marouncz/GraviGon/boards.png

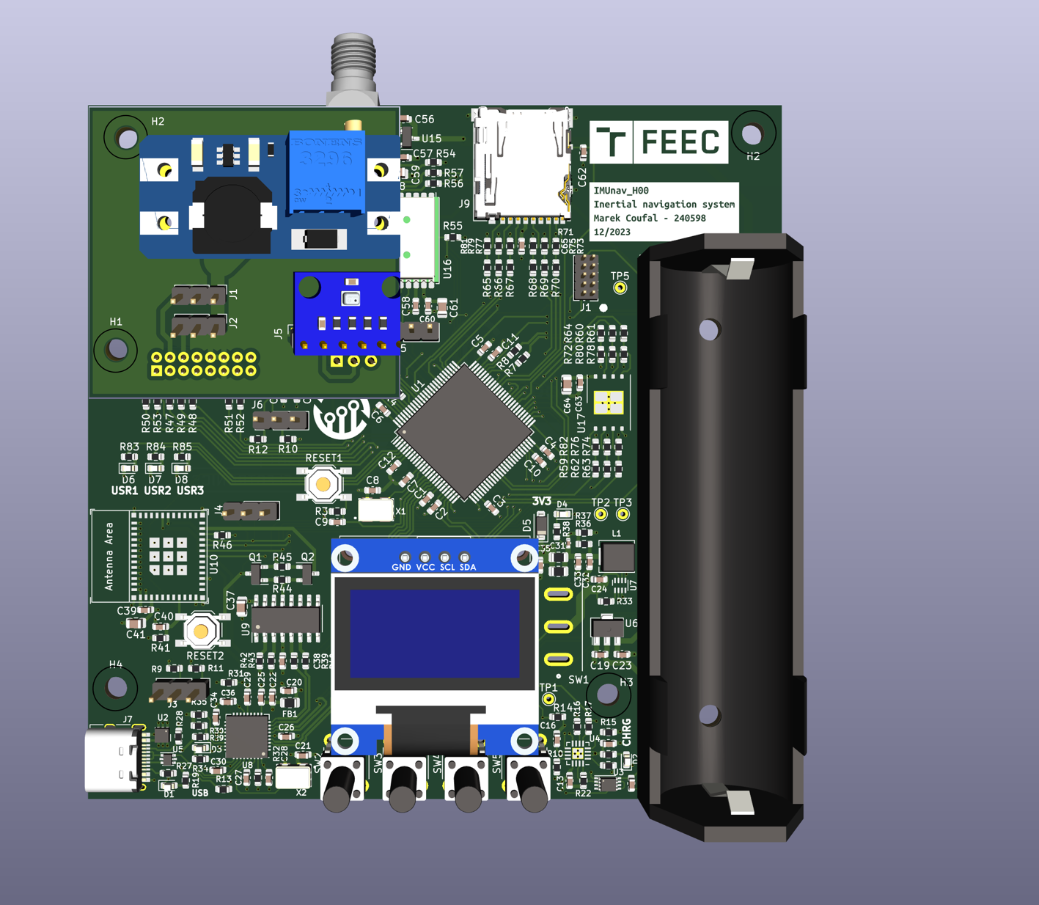
boards.png
