marouncz/GraviGon/boardReal.jpg

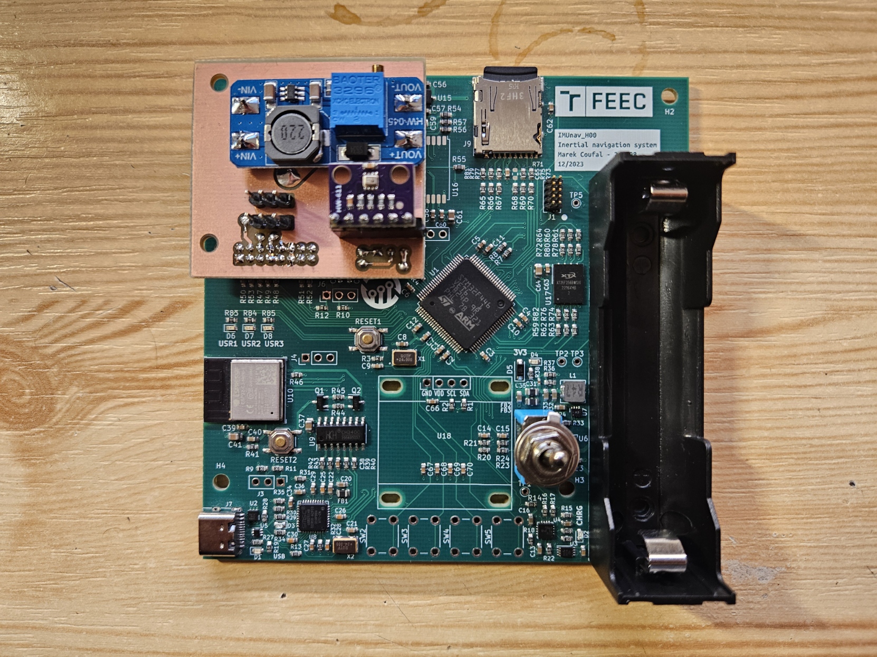
boardReal.jpg
