marouncz/GraviGon/Mechanics/NDE_CubeSat_v2/Cubesat/Cubesat_Go.pdf

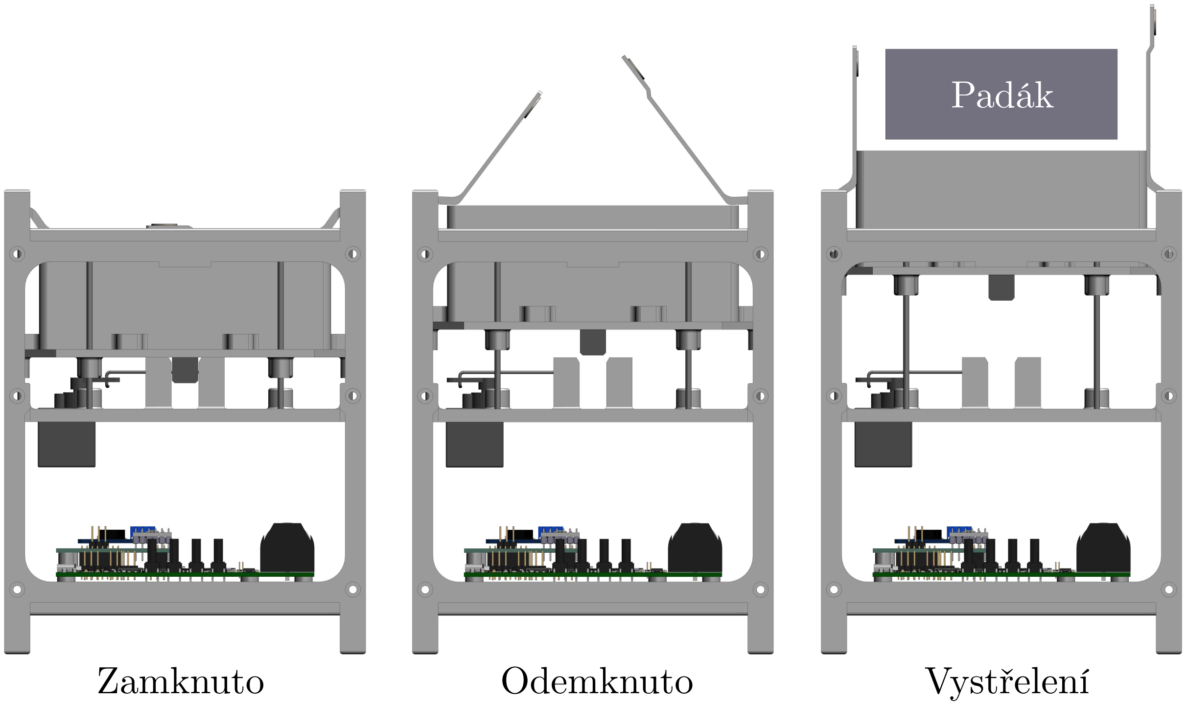
[picture p3: page 1]

Zamknuto | Odemknuto | Vystřelení

Padák
