marouncz/GraviGon/boardMating.png

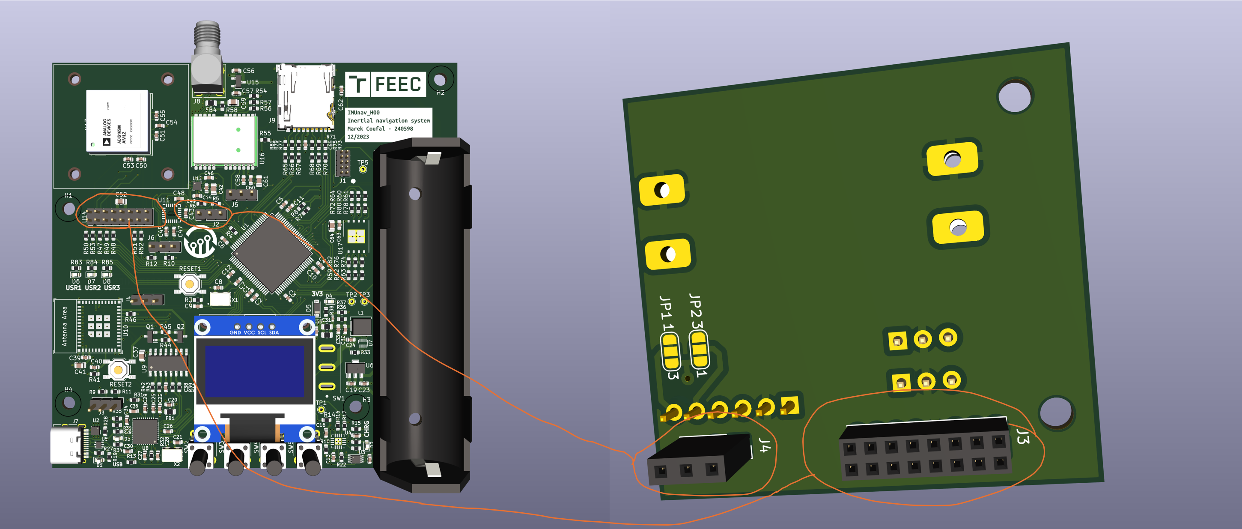
boardMating.png
