marouncz/GraviGon/Mechanics/NDE_CubeSat_v2/Cubesat/Center_of_mass_MPU6050_2.jpg

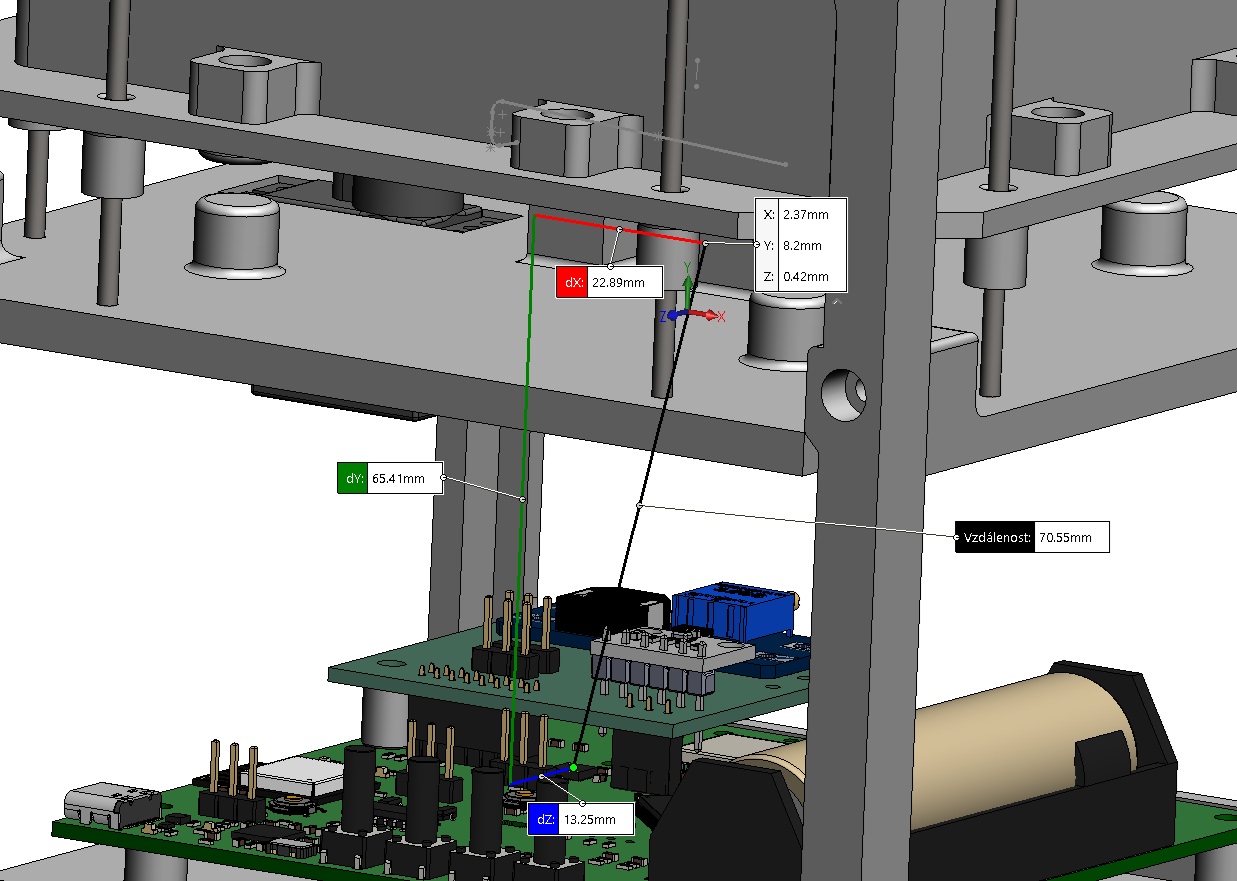
Mechanics/NDE_CubeSat_v2/Cubesat/Center_of_mass_MPU6050_2.jpg
