marouncz/GraviGon/Mechanics/NDE_CubeSat_v2/Cubesat/Cubesat.jpg

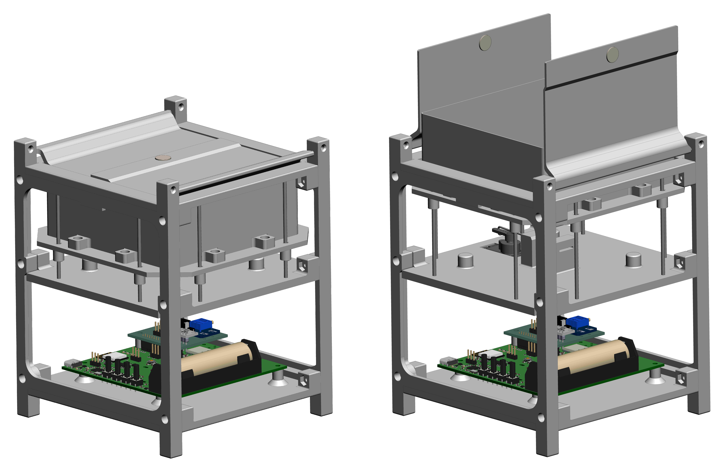
Mechanics/NDE_CubeSat_v2/Cubesat/Cubesat.jpg
