marouncz/GraviGon/Mechanics/NDE_CubeSat_v2/Cubesat/Cubesat_Go_1.JPG

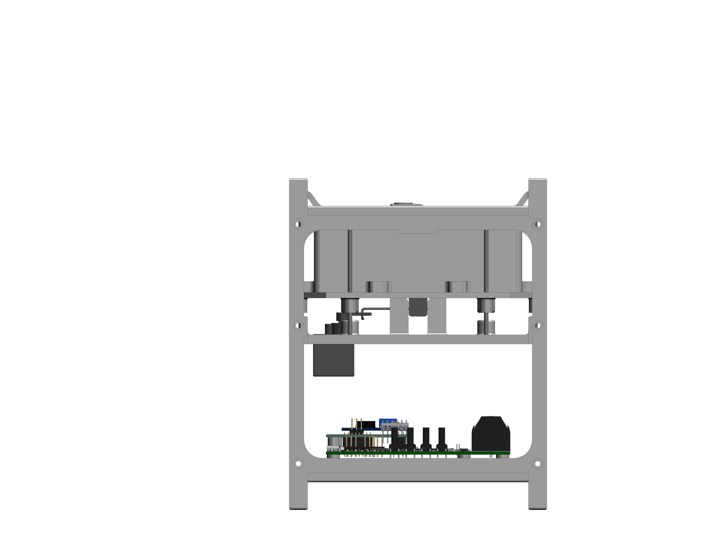
Mechanics/NDE_CubeSat_v2/Cubesat/Cubesat_Go_1.JPG
