marouncz/GraviGon/Mechanics/NDE_CubeSat_v2/Cubesat/Cubesat_Go_3.JPG

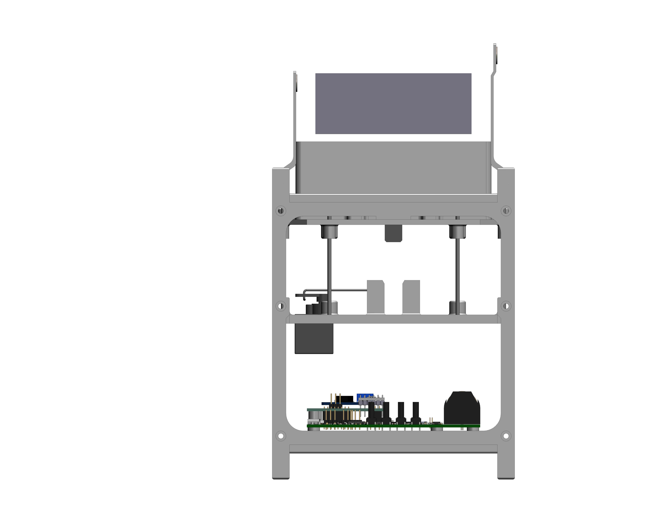
Mechanics/NDE_CubeSat_v2/Cubesat/Cubesat_Go_3.JPG
