marouncz/GraviGon/Mechanics/NDE_CubeSat_v2/Cubesat/Cubesat_Mooving_Part.JPG

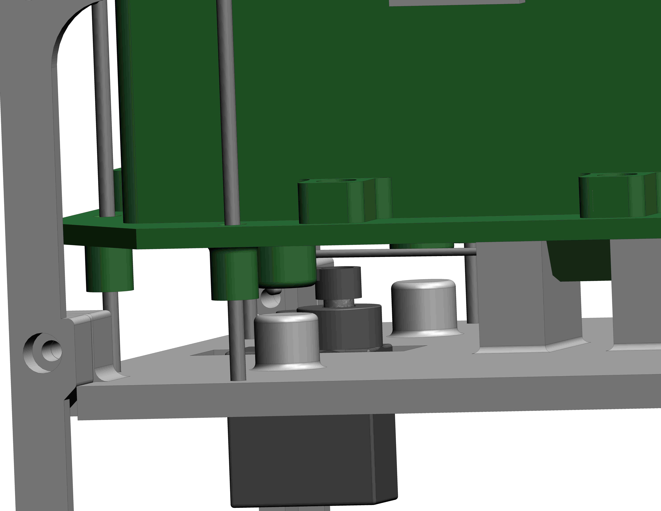
Mechanics/NDE_CubeSat_v2/Cubesat/Cubesat_Mooving_Part.JPG
