marouncz/GraviGon/Mechanics/NDE_CubeSat_v2/Cubesat/Cubesat_Release_1.JPG

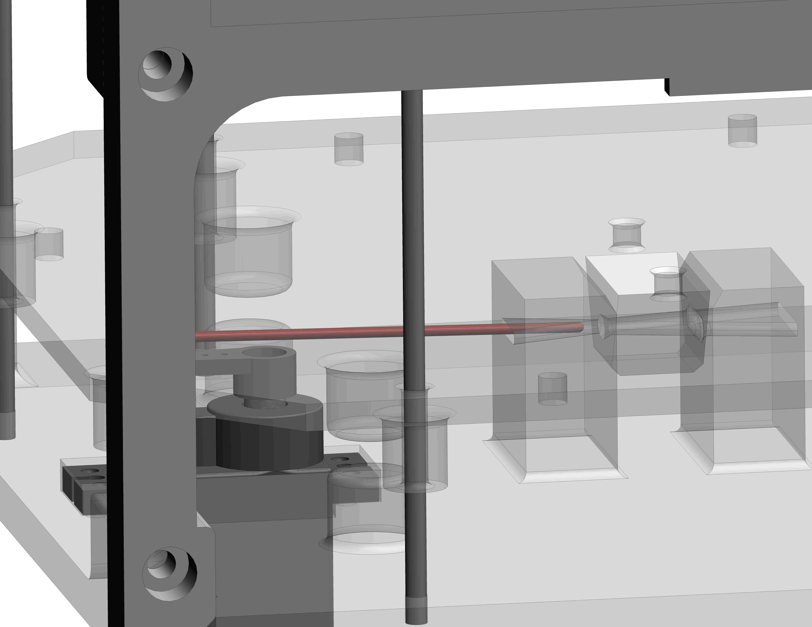
Mechanics/NDE_CubeSat_v2/Cubesat/Cubesat_Release_1.JPG
