marouncz/GraviGon/Mechanics/NDE_CubeSat_v2/Cubesat/Cubesat_Release_DPI300.jpg

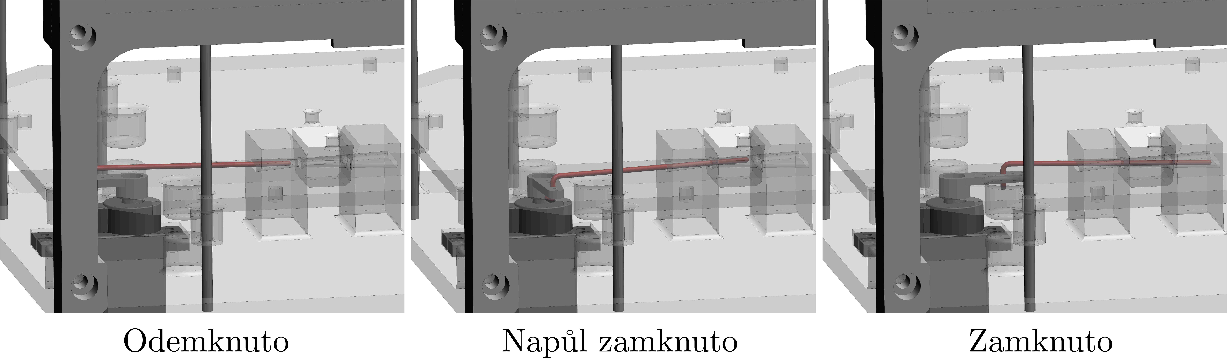
Mechanics/NDE_CubeSat_v2/Cubesat/Cubesat_Release_DPI300.jpg
