marouncz/GraviGon/Mechanics/NDE_CubeSat_v2/Cubesat/Print_Parts_Progress.xlsx

Filename | pcs | infill | progress
Cubesat_Bottom.STL | 1 | 30% |  | done
Cubesat_Middle.STL | 1 | 50% |  | printing
Cubesat_Moving_Part_v2.STL | 1 | 90% |  | to do
Cubesat_Side.STL | 2 | 50%
Cubesat_Side_Parachute_Cover.STL | 1 | 90%
Cubesat_Top.STL | 1 | 30%
Cubesat_Top_Cover_Right.STL | 1 | 90%
Cubesat_Top_Cover_Left.STL | 1 | 90%
