marouncz/GraviGon/Mechanics/NDE_CubeSat_v2/Cubesat/BOM_Screws_Nuts.xlsx

Part | pcs | info | take
DIN 912 M3x16 | 16 | imbus šroub s válcovou hlavou | 20
DIN 912 M3x26 | 1 | imbus šroub s válcovou hlavou | 2
DIN 912 M3x10 | 8 | imbus šroub s válcovou hlavou | 10
DIN 912 M2x6 | 2 | imbus šroub s válcovou hlavou | 4
DIN 912 M2x14 | 1 | imbus šroub s válcovou hlavou | 2
DIN 934 M3 | 25 | hex matice | 30
DIN 934 M2 | 3 | hex matice | 6
