marouncz/GraviGon/Mechanics/NDE_CubeSat_v2/Cubesat/Cubesat_SG90.SLDASM

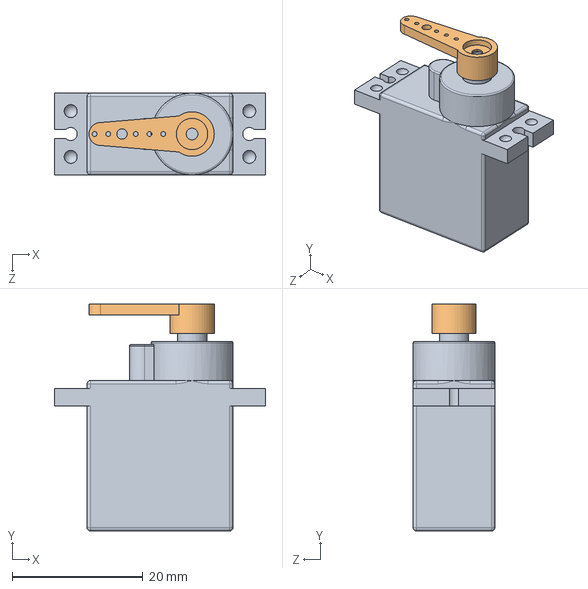
[picture p14: CAD file, 2025-05-04]
Mechanics/NDE_CubeSat_v2/Cubesat/Cubesat_SG90.SLDASM
32.3 x 34.7 x 12.5 mm
Cubesat_SG90_Body
Cubesat_SG90_Moving_Part
