marouncz/GraviGon/Mechanics/NDE_CubeSat_v2/Board/IMUnav_H00_Addon.SLDASM

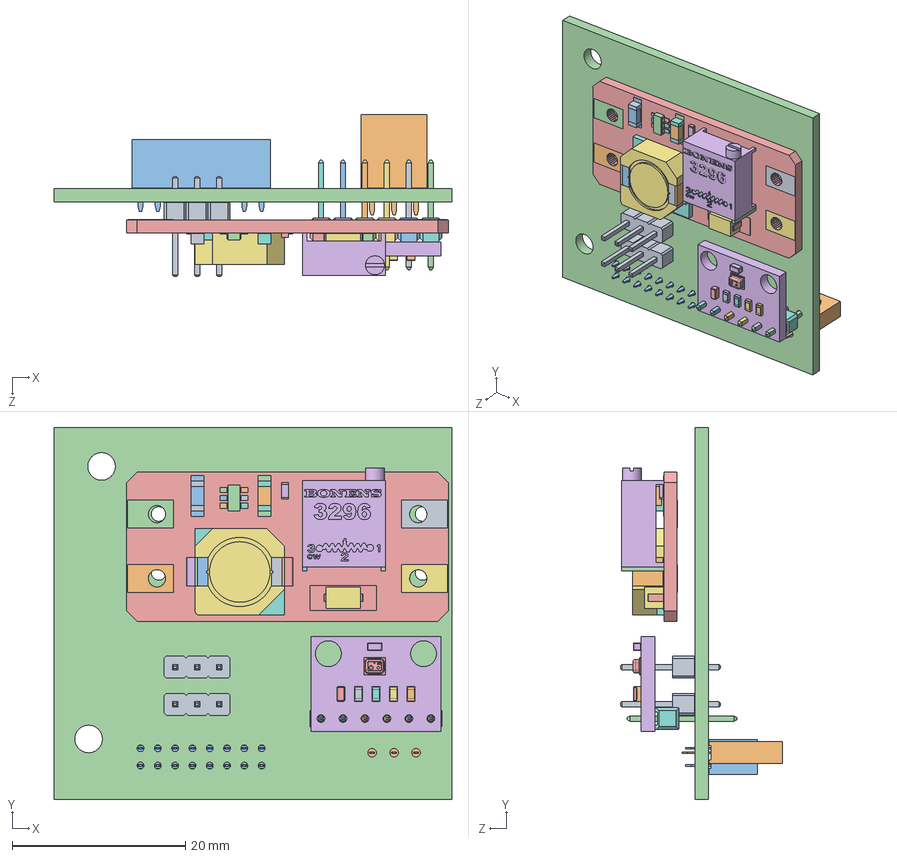
[picture p15: CAD file, 2025-04-14]
Mechanics/NDE_CubeSat_v2/Board/IMUnav_H00_Addon.SLDASM
46.0 x 43.0 x 18.7 mm
MT3608 v3
MT3608 v3_44
MT3608 v3_28
MT3608 v3_26
MT3608 v3_13
MT3608 v3_41
MT3608 v3_11
MT3608 v3_29
MT3608 v3_42
MT3608 v3_43
MT3608 v3_15
MT3608 v3_16
MT3608 v3_14
MT3608 v3_30
MT3608 v3_39
MT3608 v3_9
MT3608 v3_10
MT3608 v3_12
MT3608 v3_31
MT3608 v3_17
MT3608 v3_8
MT3608 v3_40
MT3608 v3_27
MT3608 v3_2
MT3608 v3_33
MT3608 v3_3
MT3608 v3_18
MT3608 v3_19
MT3608 v3_22
MT3608 v3_4
MT3608 v3_35
MT3608 v3_20
MT3608 v3_34
MT3608 v3_5
MT3608 v3_6
MT3608 v3_21
MT3608 v3_7
MT3608 v3_23
MT3608 v3_37
MT3608 v3_38
MT3608 v3_36
MT3608 v3_24
MT3608 v3_25
MT3608 v3_32
bmp280_module_Shrinkwrap
bmp280_module_Shrinkwrap_16
bmp280_module_Shrinkwrap_10
bmp280_module_Shrinkwrap_9
bmp280_module_Shrinkwrap_2
bmp280_module_Shrinkwrap_17
bmp280_module_Shrinkwrap_5
bmp280_module_Shrinkwrap_13
bmp280_module_Shrinkwrap_12
bmp280_module_Shrinkwrap_11
bmp280_module_Shrinkwrap_19
bmp280_module_Shrinkwrap_6
bmp280_module_Shrinkwrap_7
bmp280_module_Shrinkwrap_15
bmp280_module_Shrinkwrap_4
bmp280_module_Shrinkwrap_8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
