marouncz/GraviGon/Electronics/IMUnav_Gravi_Addon/bmp280_module.stp

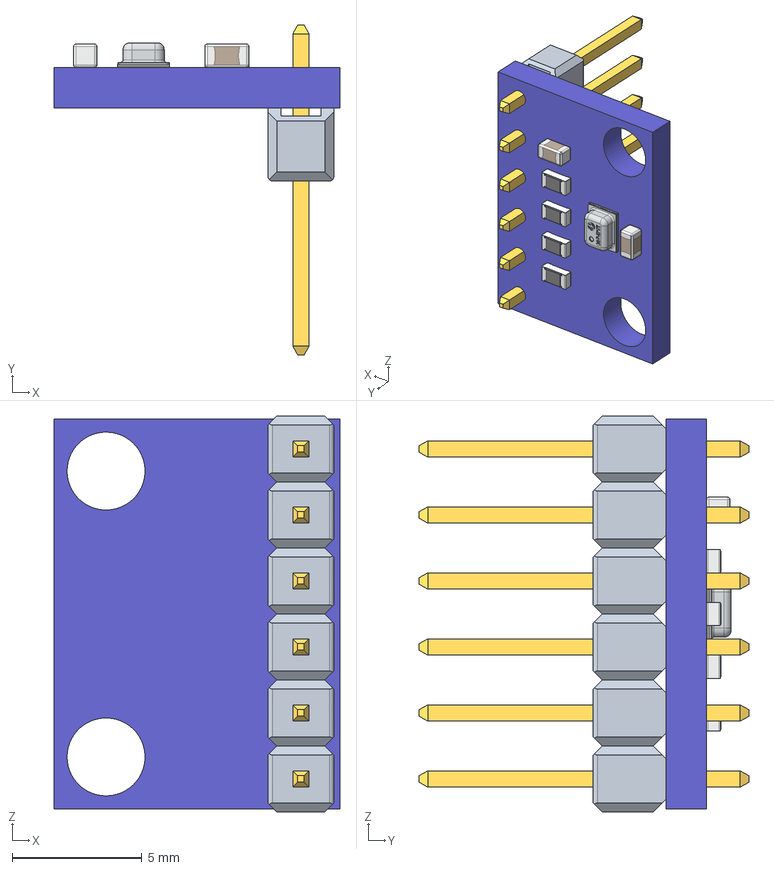
[picture p16: CAD file, 2025-02-20]
Electronics/IMUnav_Gravi_Addon/bmp280_module.stp
11.0 x 12.7 x 15.2 mm
