marouncz/GraviGon/Mechanics/NDE_CubeSat_v2/Cubesat/Cubesat_Moving_Part_v2.SLDPRT

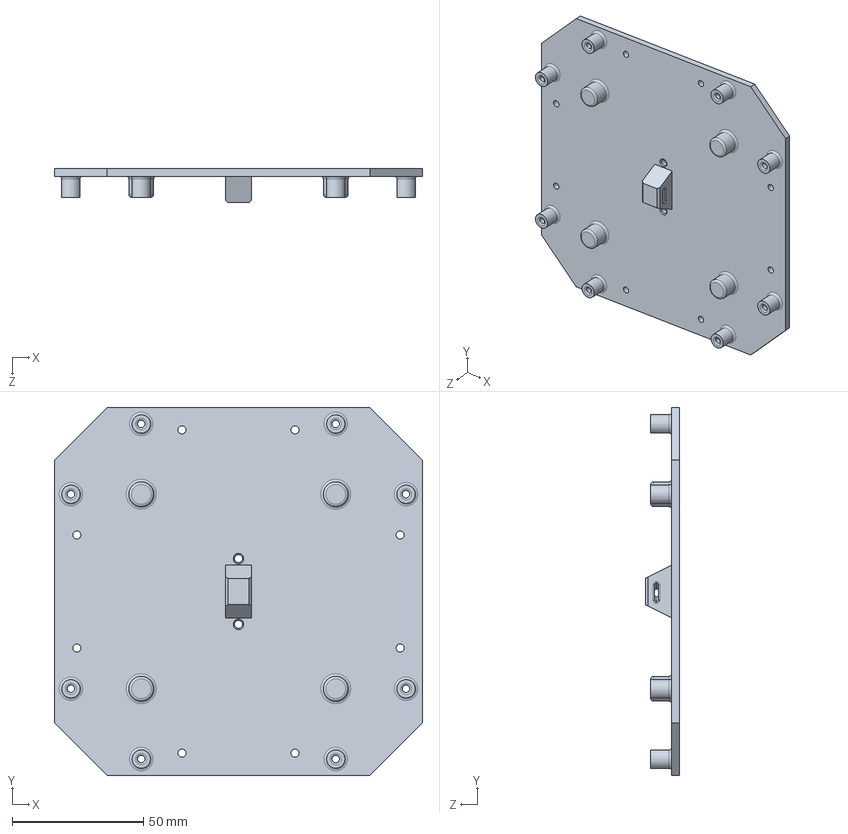
[picture p17: CAD file, 2025-05-04]
Mechanics/NDE_CubeSat_v2/Cubesat/Cubesat_Moving_Part_v2.SLDPRT
140.0 x 140.0 x 13.0 mm
