marouncz/GraviGon/Electronics/IMUnav_Gravi_Addon/MT3608 v3.step

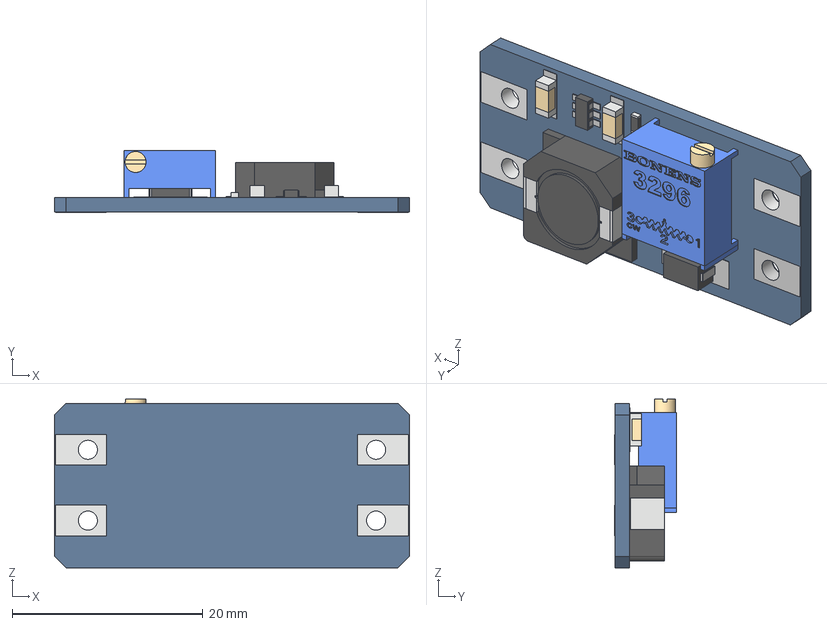
[picture p18: CAD file, 2025-02-20]
Electronics/IMUnav_Gravi_Addon/MT3608 v3.step
37.2 x 6.49 x 17.7 mm
