marouncz/GraviGon/Mechanics/NDE_CubeSat_v2/Cubesat/Cubesat_Fuse_Wire.SLDPRT

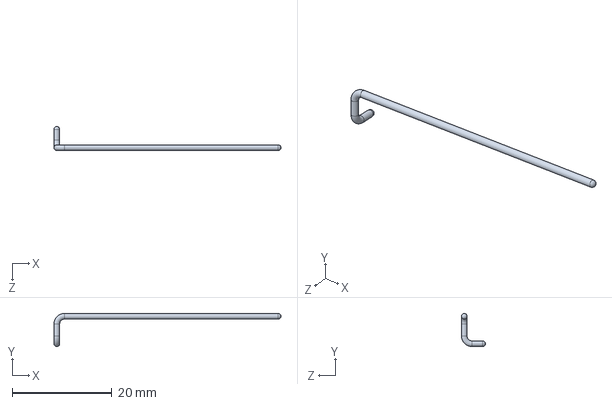
[picture p19: CAD file, 2025-05-04]
Mechanics/NDE_CubeSat_v2/Cubesat/Cubesat_Fuse_Wire.SLDPRT
45.6 x 6.65 x 4.83 mm
