marouncz/GraviGon/Mechanics/NDE_CubeSat_v2/Cubesat/Cubesat_Side_Parachute_Cover.SLDPRT

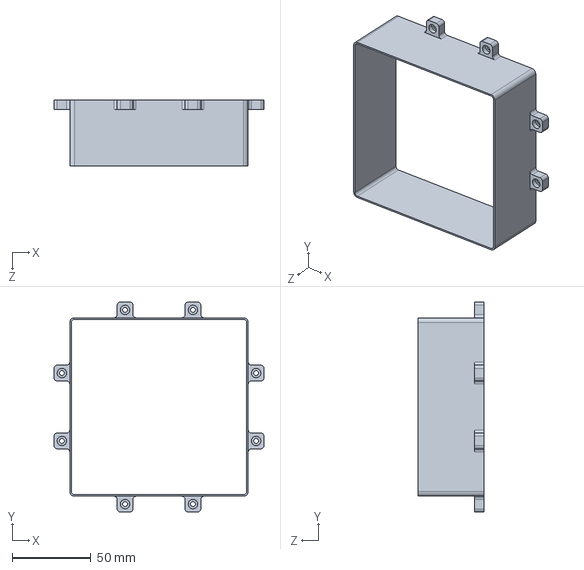
[picture p20: CAD file, 2025-05-04]
Mechanics/NDE_CubeSat_v2/Cubesat/Cubesat_Side_Parachute_Cover.SLDPRT
133.0 x 133.0 x 42.0 mm
