marouncz/GraviGon/Mechanics/NDE_CubeSat_v2/Cubesat/Cubesat_Side.SLDPRT

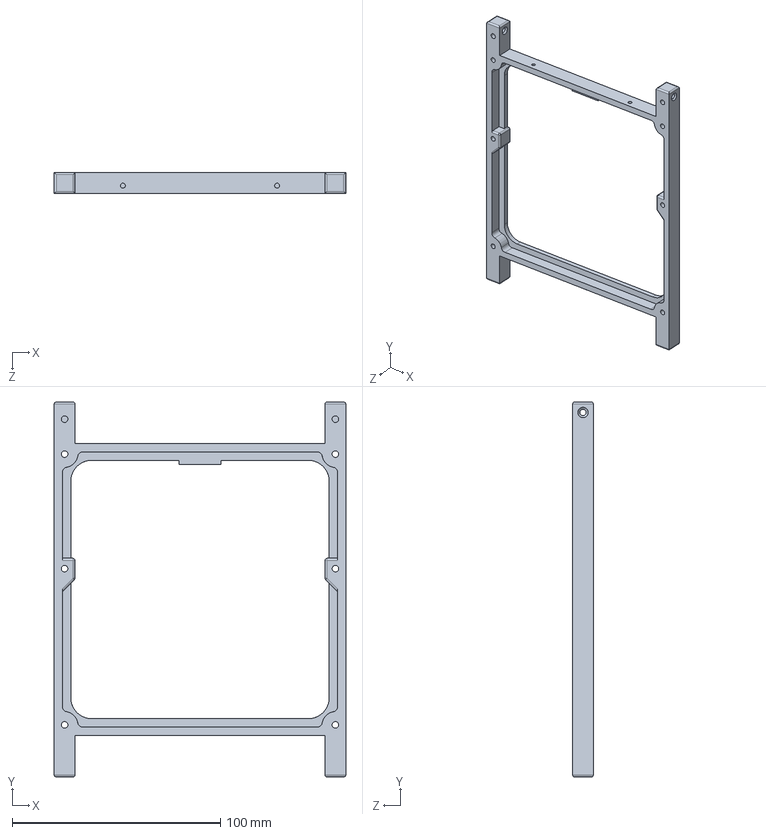
[picture p22: CAD file, 2025-04-14]
Mechanics/NDE_CubeSat_v2/Cubesat/Cubesat_Side.SLDPRT
140.0 x 180.0 x 10.0 mm
