marouncz/GraviGon/Mechanics/NDE_CubeSat_v2/Cubesat/Cubesat_SG90_Body.SLDPRT

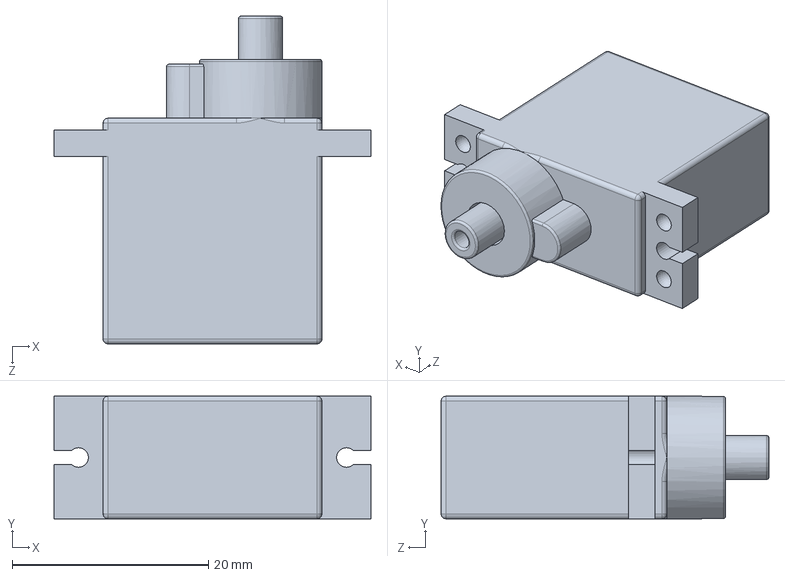
[picture p23: CAD file, 2025-04-14]
Mechanics/NDE_CubeSat_v2/Cubesat/Cubesat_SG90_Body.SLDPRT
32.3 x 12.5 x 33.4 mm
