marouncz/GraviGon/Mechanics/NDE_CubeSat_v2/Cubesat/Cubesat_SG90_Moving_Part.SLDPRT

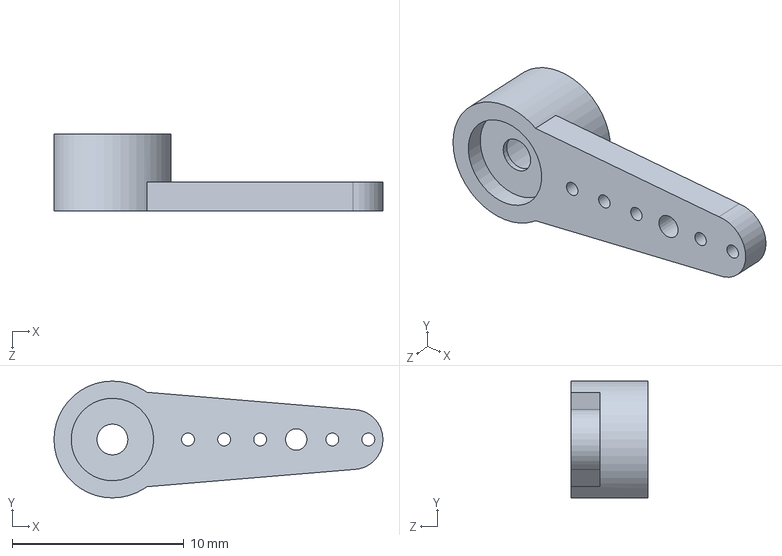
[picture p24: CAD file, 2025-04-14]
Mechanics/NDE_CubeSat_v2/Cubesat/Cubesat_SG90_Moving_Part.SLDPRT
19.1 x 6.80 x 4.50 mm
