marouncz/GraviGon/Mechanics/NDE_CubeSat_v2/Board/Board.SLDPRT

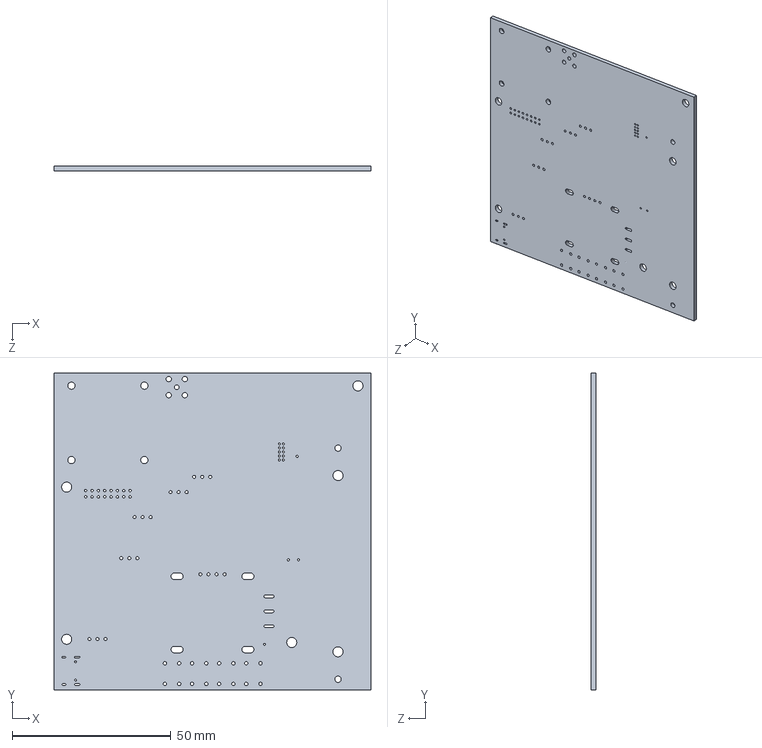
[picture p25: CAD file, 2025-04-14]
Mechanics/NDE_CubeSat_v2/Board/Board.SLDPRT
100.0 x 100.0 x 1.65 mm
