marouncz/GraviGon/Mechanics/NDE_CubeSat_v2/Cubesat/Cubesat_Parachute.SLDPRT

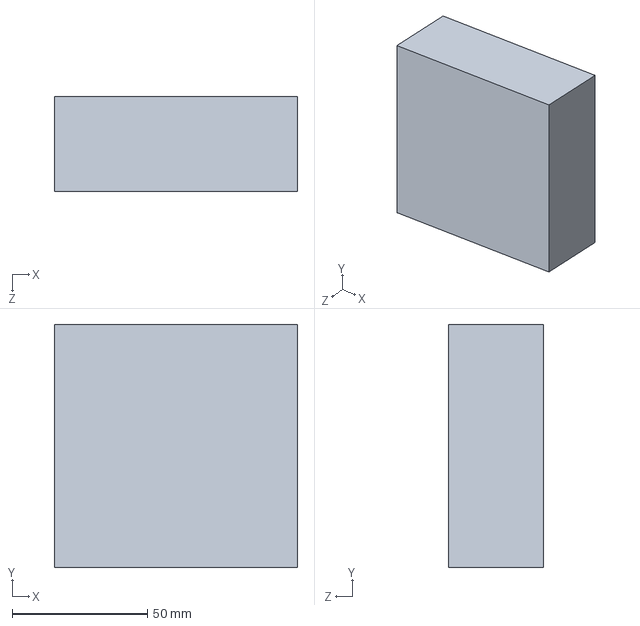
[picture p26: CAD file, 2025-04-14]
Mechanics/NDE_CubeSat_v2/Cubesat/Cubesat_Parachute.SLDPRT
90.0 x 90.0 x 35.0 mm
