marouncz/GraviGon/Mechanics/NDE_CubeSat_v2/Cubesat/Cubesat_Spacer_Real.SLDPRT

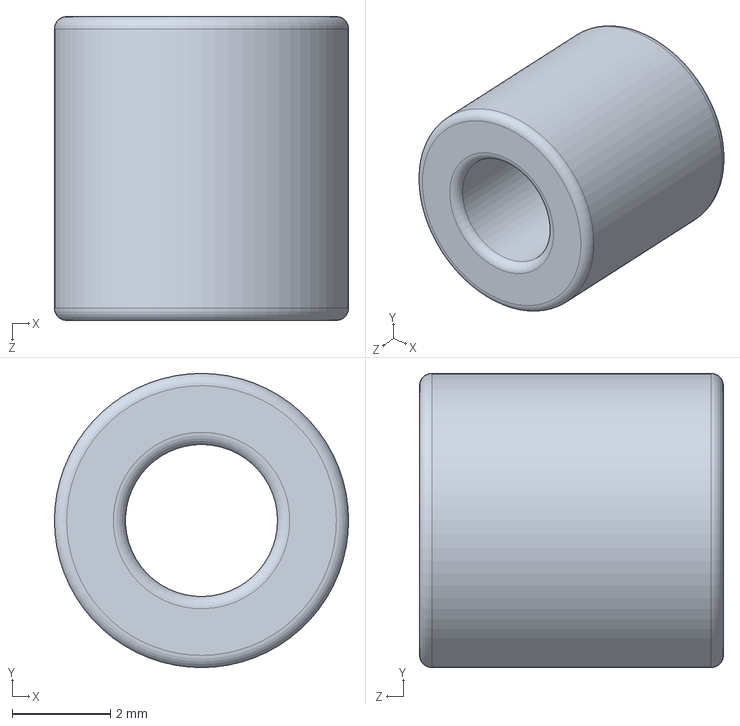
[picture p27: CAD file, 2025-04-14]
Mechanics/NDE_CubeSat_v2/Cubesat/Cubesat_Spacer_Real.SLDPRT
6.00 x 6.00 x 6.20 mm
