marouncz/GraviGon/Mechanics/NDE_CubeSat_v2/Cubesat/Cubesat_Top_Cover_Right.STL

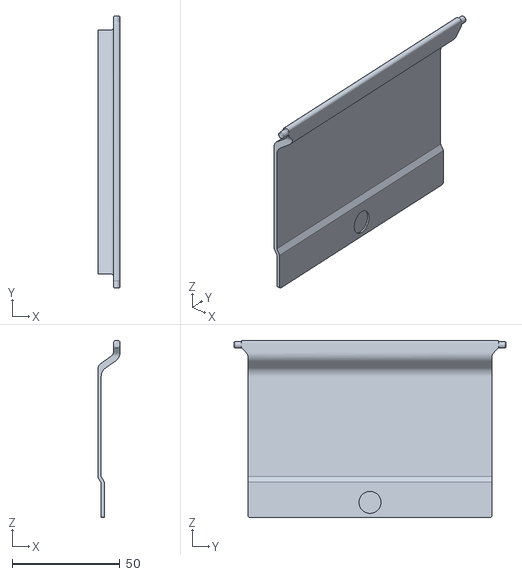
[picture p28: CAD file, 2025-04-14]
Mechanics/NDE_CubeSat_v2/Cubesat/Cubesat_Top_Cover_Right.STL
10.2 x 126.0 x 82.0
