marouncz/GraviGon/Mechanics/NDE_CubeSat_v2/Cubesat/Cubesat_Top_Cover.SLDPRT

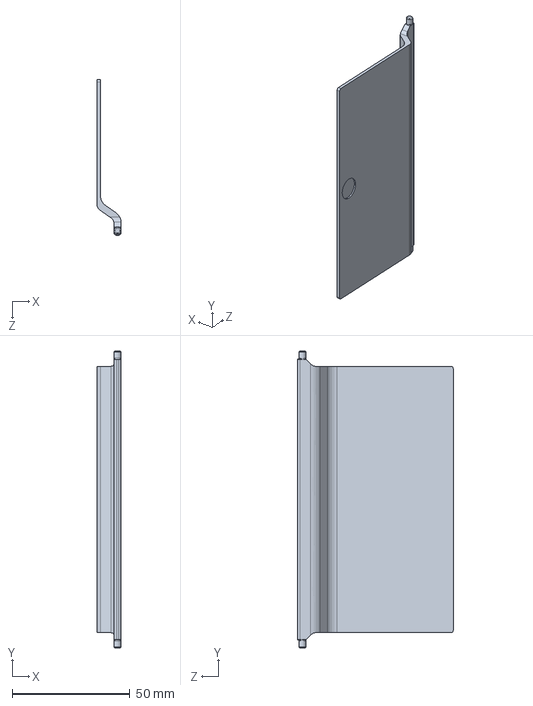
[picture p29: CAD file, 2025-04-14]
Mechanics/NDE_CubeSat_v2/Cubesat/Cubesat_Top_Cover.SLDPRT
10.2 x 126.0 x 66.0 mm
