marouncz/GraviGon/Mechanics/NDE_CubeSat_v2/Cubesat/Cubesat_Middle.SLDPRT

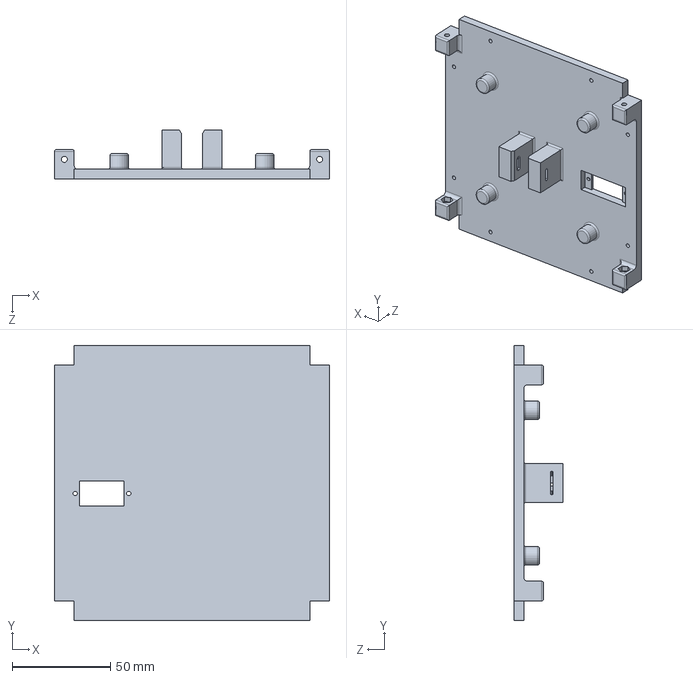
[picture p30: CAD file, 2025-04-14]
Mechanics/NDE_CubeSat_v2/Cubesat/Cubesat_Middle.SLDPRT
140.0 x 140.0 x 25.0 mm
