marouncz/GraviGon/Mechanics/NDE_CubeSat_v2/Cubesat/Cubesat_Wire.SLDPRT

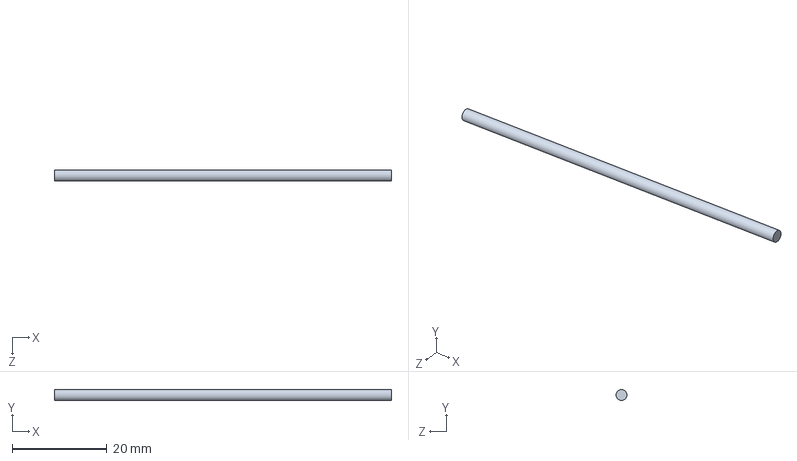
[picture p31: CAD file, 2025-04-14]
Mechanics/NDE_CubeSat_v2/Cubesat/Cubesat_Wire.SLDPRT
71.0 x 2.30 x 2.30 mm
