marouncz/GraviGon/Mechanics/NDE_CubeSat_v2/Cubesat/Cubesat_Top.SLDPRT

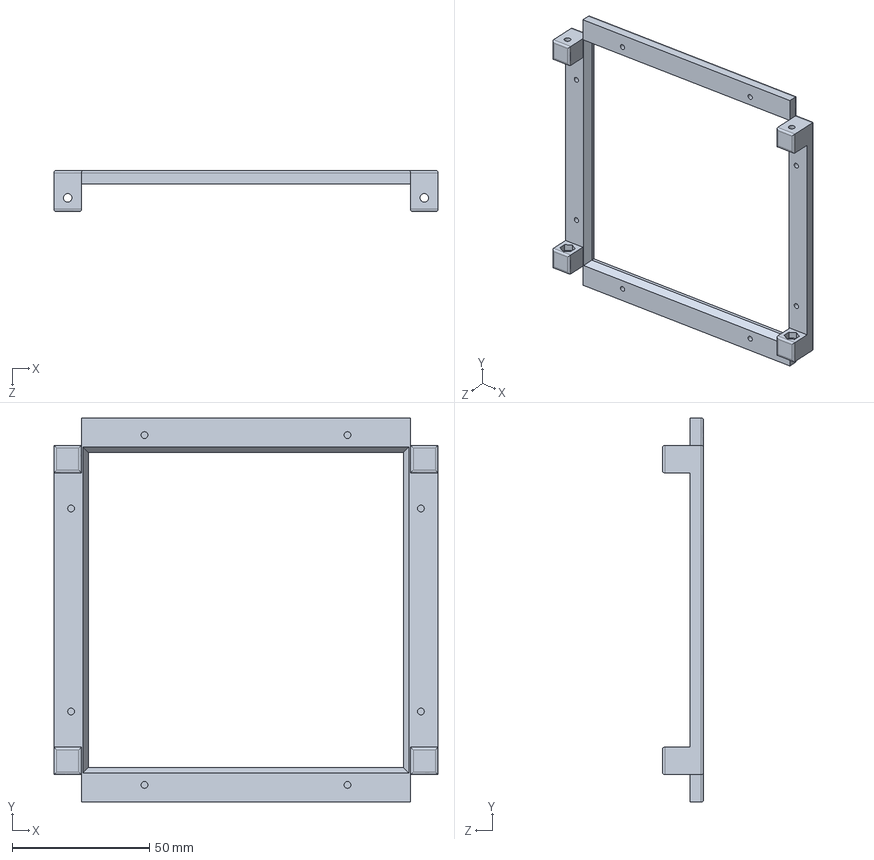
[picture p32: CAD file, 2025-04-14]
Mechanics/NDE_CubeSat_v2/Cubesat/Cubesat_Top.SLDPRT
140.0 x 140.0 x 15.0 mm
