marouncz/GraviGon/Mechanics/NDE_CubeSat_v2/Cubesat/Cubesat_Spacer.SLDPRT

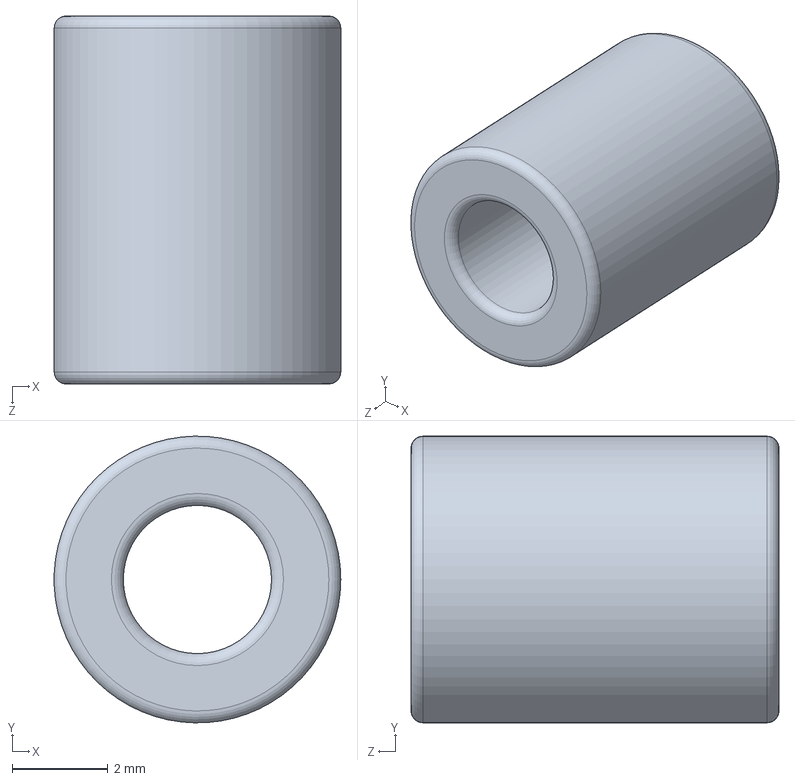
[picture p33: CAD file, 2025-04-14]
Mechanics/NDE_CubeSat_v2/Cubesat/Cubesat_Spacer.SLDPRT
6.00 x 6.00 x 7.70 mm
