marouncz/GraviGon/Mechanics/NDE_CubeSat_v2/Cubesat/Cubesat_Neodymium_Magnet.SLDPRT

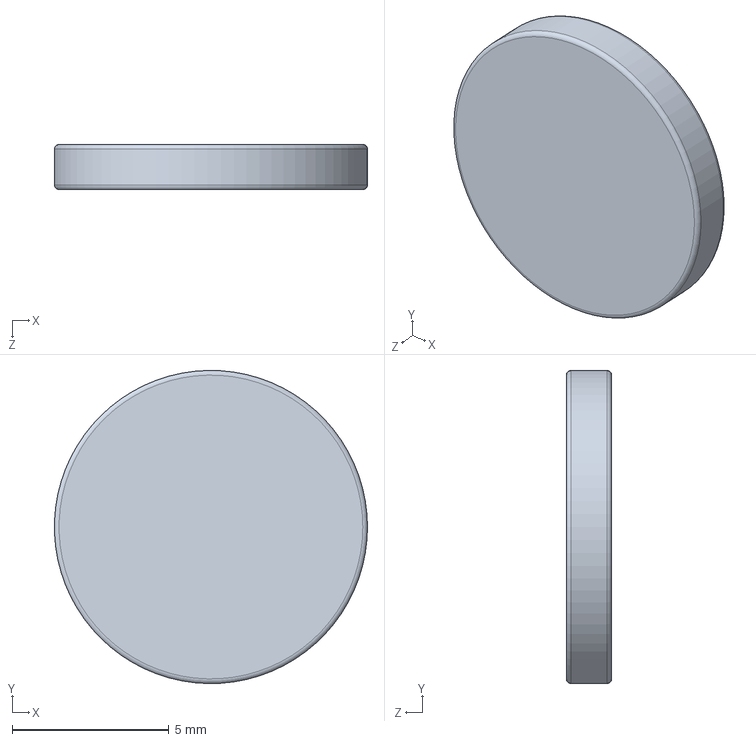
[picture p34: CAD file, 2025-04-14]
Mechanics/NDE_CubeSat_v2/Cubesat/Cubesat_Neodymium_Magnet.SLDPRT
10.00 x 10.00 x 1.45 mm
