marouncz/GraviGon/Mechanics/NDE_CubeSat_v2/Cubesat/Cubesat_18650.SLDPRT

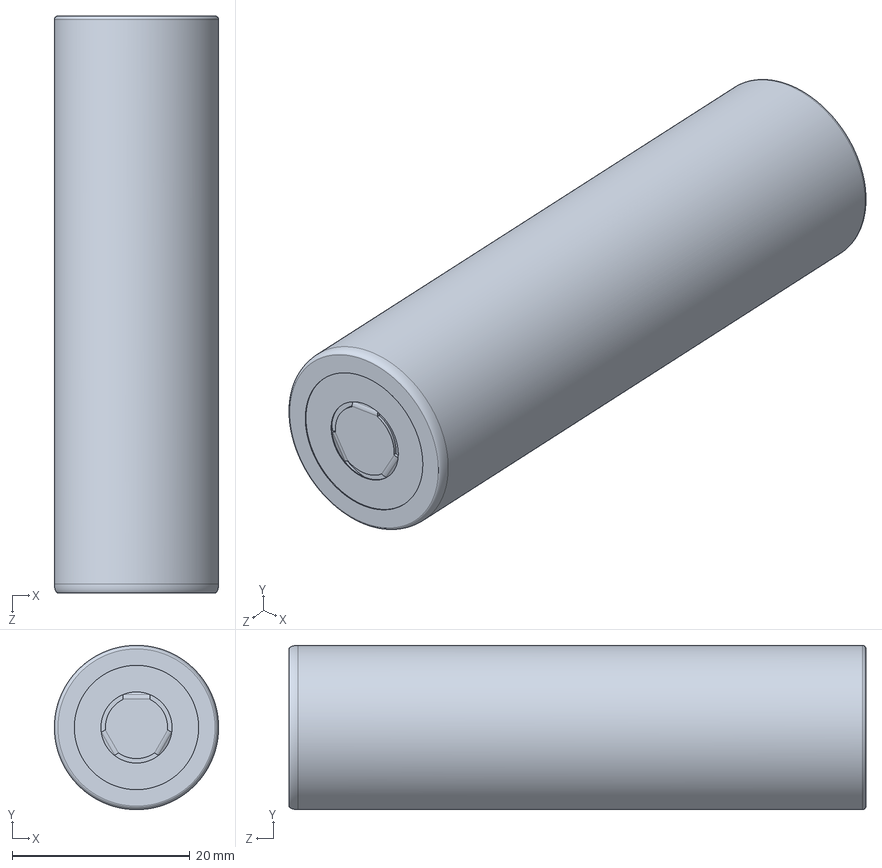
[picture p35: CAD file, 2025-04-14]
Mechanics/NDE_CubeSat_v2/Cubesat/Cubesat_18650.SLDPRT
18.5 x 18.5 x 65.0 mm
