marouncz/GraviGon/(list of files, cad)

Other CAD files:
Mechanics/NDE_CubeSat_v2/Board/ECS-5032MV-240-CN-TR.SLDASM
Mechanics/NDE_CubeSat_v2/Board/LQFP-100_14x14mm_P0.5mm.SLDASM
Mechanics/NDE_CubeSat_v2/Board/LGA-12_2x2mm_P0.5mm.SLDASM
Mechanics/NDE_CubeSat_v2/Board/SOT-89-3.SLDASM
Mechanics/NDE_CubeSat_v2/Board/R_0603_1608Metric.SLDASM
Mechanics/NDE_CubeSat_v2/Board/PinSocket_1x03_P2.54mm_Vertical.SLDASM
Mechanics/NDE_CubeSat_v2/Board/falcon-assembly.SLDASM
Mechanics/NDE_CubeSat_v2/Board/SW_PUSH_6mm_H13mm.SLDASM
Mechanics/NDE_CubeSat_v2/Board/PinHeader_2x08_P2.00mm_Vertical.SLDASM
Mechanics/NDE_CubeSat_v2/Board/WSON-6-1EP_2x2mm_P0.65mm_EP1x1.6mm.SLDASM
Mechanics/NDE_CubeSat_v2/Board/bmp280_module.SLDASM
Mechanics/NDE_CubeSat_v2/Board/BatteryHolder_MPD_BH-18650-PC2.SLDASM
Mechanics/NDE_CubeSat_v2/Board/SOT-23.SLDASM
Mechanics/NDE_CubeSat_v2/Board/C_0805_2012Metric.SLDASM
Mechanics/NDE_CubeSat_v2/Board/MT3608 v3.SLDASM
Mechanics/NDE_CubeSat_v2/Board/QFN-24-1EP_4x4mm_P0.5mm_EP2.7x2.6mm.SLDASM
Mechanics/NDE_CubeSat_v2/Board/LED_0603_1608Metric.SLDASM
Mechanics/NDE_CubeSat_v2/Board/QFN-36-1EP_6x6mm_P0.5mm_EP3.7x3.7mm.SLDASM
Mechanics/NDE_CubeSat_v2/Board/VSSOP-8_2.3x2mm_P0.5mm.SLDASM
Mechanics/NDE_CubeSat_v2/Board/C_0603_1608Metric.SLDASM
Mechanics/NDE_CubeSat_v2/Board/NEO-M8U Ublox Module.SLDASM
Mechanics/NDE_CubeSat_v2/Board/PinHeader_2x05_P1.27mm_Vertical.SLDASM
Mechanics/NDE_CubeSat_v2/Board/R_0805_2012Metric.SLDASM
Mechanics/NDE_CubeSat_v2/Board/C_0402_1005Metric.SLDASM
Mechanics/NDE_CubeSat_v2/Board/PinSocket_2x08_P2.00mm_Vertical.SLDASM
Mechanics/NDE_CubeSat_v2/Board/ESP32-C3-MINI-1.SLDASM
Mechanics/NDE_CubeSat_v2/Board/HRO_TYPE-C-31-M-12.SLDASM
Mechanics/NDE_CubeSat_v2/Board/SW_SPST_TL3342.SLDASM
Mechanics/NDE_CubeSat_v2/Board/PinHeader_1x03_P2.54mm_Vertical.SLDASM
Mechanics/NDE_CubeSat_v2/Board/SOT-666.SLDASM
Mechanics/NDE_CubeSat_v2/Board/SOIC-16_3.9x9.9mm_P1.27mm.SLDASM
Mechanics/NDE_CubeSat_v2/Board/D_SOD-123.SLDASM
Mechanics/NDE_CubeSat_v2/Board/DM3AT-SF-PEJM5.SLDASM
Mechanics/NDE_CubeSat_v2/Board/COMPOUND_426.SLDPRT
Mechanics/NDE_CubeSat_v2/Board/bmp280_module_Shrinkwrap_3.SLDPRT
Mechanics/NDE_CubeSat_v2/Board/COMPOUND_384.SLDPRT
Mechanics/NDE_CubeSat_v2/Board/COMPOUND_30.SLDPRT
Mechanics/NDE_CubeSat_v2/Board/COMPOUND_259.SLDPRT
Mechanics/NDE_CubeSat_v2/Board/COMPOUND_229.SLDPRT
Mechanics/NDE_CubeSat_v2/Board/COMPOUND_381.SLDPRT
Mechanics/NDE_CubeSat_v2/Board/COMPOUND_205.SLDPRT
Mechanics/NDE_CubeSat_v2/Board/COMPOUND_207.SLDPRT
Mechanics/NDE_CubeSat_v2/Board/COMPOUND_137.SLDPRT
Mechanics/NDE_CubeSat_v2/Board/COMPOUND_410.SLDPRT
Mechanics/NDE_CubeSat_v2/Board/COMPOUND_17.SLDPRT
Mechanics/NDE_CubeSat_v2/Board/COMPOUND_275.SLDPRT
Mechanics/NDE_CubeSat_v2/Board/COMPOUND_499.SLDPRT
Mechanics/NDE_CubeSat_v2/Cubesat/Cubesat_Top_Cover_Left.STL
Mechanics/NDE_CubeSat_v2/Board/COMPOUND_328.SLDPRT
Mechanics/NDE_CubeSat_v2/Board/COMPOUND_73.SLDPRT
Mechanics/NDE_CubeSat_v2/Board/COMPOUND_148.SLDPRT
Mechanics/NDE_CubeSat_v2/Board/COMPOUND_158.SLDPRT
Mechanics/NDE_CubeSat_v2/Board/COMPOUND_82.SLDPRT
Mechanics/NDE_CubeSat_v2/Board/COMPOUND_459.SLDPRT
Mechanics/NDE_CubeSat_v2/Board/COMPOUND_393.SLDPRT
Mechanics/NDE_CubeSat_v2/Board/COMPOUND_193.SLDPRT
Mechanics/NDE_CubeSat_v2/Board/COMPOUND_392.SLDPRT
Mechanics/NDE_CubeSat_v2/Board/COMPOUND_231.SLDPRT
Mechanics/NDE_CubeSat_v2/Board/COMPOUND_399.SLDPRT
Mechanics/NDE_CubeSat_v2/Board/SOLID_25.SLDPRT
Mechanics/NDE_CubeSat_v2/Board/COMPOUND_111.SLDPRT
Mechanics/NDE_CubeSat_v2/Board/COMPOUND_269.SLDPRT
Mechanics/NDE_CubeSat_v2/Board/COMPOUND_191.SLDPRT
Mechanics/NDE_CubeSat_v2/Board/COMPOUND_270.SLDPRT
Mechanics/NDE_CubeSat_v2/Board/COMPOUND_264.SLDPRT
Mechanics/NDE_CubeSat_v2/Board/COMPOUND_363.SLDPRT
Mechanics/NDE_CubeSat_v2/Board/COMPOUND_469.SLDPRT
Mechanics/NDE_CubeSat_v2/Board/COMPOUND_6.SLDPRT
Mechanics/NDE_CubeSat_v2/Board/COMPOUND_245.SLDPRT
Mechanics/NDE_CubeSat_v2/Board/COMPOUND_171.SLDPRT
Mechanics/NDE_CubeSat_v2/Board/COMPOUND_40.SLDPRT
Mechanics/NDE_CubeSat_v2/Board/bmp280_module_Shrinkwrap_5.SLDPRT
Mechanics/NDE_CubeSat_v2/Board/SOLID_15.SLDPRT
Mechanics/NDE_CubeSat_v2/Board/COMPOUND_466.SLDPRT
Mechanics/NDE_CubeSat_v2/Board/COMPOUND_232.SLDPRT
Mechanics/NDE_CubeSat_v2/Board/COMPOUND_123.SLDPRT
Mechanics/NDE_CubeSat_v2/Board/COMPOUND_194.SLDPRT
Mechanics/NDE_CubeSat_v2/Board/COMPOUND_255.SLDPRT
Mechanics/NDE_CubeSat_v2/Board/PinHeader_1x03_P254mm_Vertical.SLDPRT
Mechanics/NDE_CubeSat_v2/Board/COMPOUND_185.SLDPRT
Mechanics/NDE_CubeSat_v2/Board/COMPOUND_168.SLDPRT
Mechanics/NDE_CubeSat_v2/Board/COMPOUND_375.SLDPRT
Mechanics/NDE_CubeSat_v2/Board/COMPOUND_94.SLDPRT
Mechanics/NDE_CubeSat_v2/Board/COMPOUND_24.SLDPRT
Mechanics/NDE_CubeSat_v2/Board/COMPOUND_378.SLDPRT
Mechanics/NDE_CubeSat_v2/Board/COMPOUND_160.SLDPRT
Mechanics/NDE_CubeSat_v2/Board/COMPOUND_223.SLDPRT
Mechanics/NDE_CubeSat_v2/Board/COMPOUND_286.SLDPRT
Mechanics/NDE_CubeSat_v2/Board/COMPOUND_331.SLDPRT
Mechanics/NDE_CubeSat_v2/Board/COMPOUND_297.SLDPRT
Mechanics/NDE_CubeSat_v2/Board/COMPOUND_353.SLDPRT
Mechanics/NDE_CubeSat_v2/Board/COMPOUND_47.SLDPRT
Mechanics/NDE_CubeSat_v2/Board/COMPOUND_133.SLDPRT
Mechanics/NDE_CubeSat_v2/Board/COMPOUND_66.SLDPRT
Mechanics/NDE_CubeSat_v2/Board/COMPOUND_146.SLDPRT
Mechanics/NDE_CubeSat_v2/Board/COMPOUND_336.SLDPRT
Mechanics/NDE_CubeSat_v2/Board/COMPOUND_500.SLDPRT
Mechanics/NDE_CubeSat_v2/Board/COMPOUND_84.SLDPRT
Mechanics/NDE_CubeSat_v2/Board/COMPOUND_382.SLDPRT
Mechanics/NDE_CubeSat_v2/Board/COMPOUND_289.SLDPRT
Mechanics/NDE_CubeSat_v2/Board/COMPOUND_349.SLDPRT
Mechanics/NDE_CubeSat_v2/Board/COMPOUND_101.SLDPRT
Mechanics/NDE_CubeSat_v2/Board/COMPOUND_179.SLDPRT
Mechanics/NDE_CubeSat_v2/Board/SOLID_23.SLDPRT
Mechanics/NDE_CubeSat_v2/Board/COMPOUND_340.SLDPRT
Mechanics/NDE_CubeSat_v2/Board/COMPOUND_195.SLDPRT
Mechanics/NDE_CubeSat_v2/Board/COMPOUND_121.SLDPRT
Mechanics/NDE_CubeSat_v2/Board/COMPOUND_387.SLDPRT
Mechanics/NDE_CubeSat_v2/Board/COMPOUND_478.SLDPRT
Mechanics/NDE_CubeSat_v2/Board/COMPOUND_356.SLDPRT
Mechanics/NDE_CubeSat_v2/Board/COMPOUND_138.SLDPRT
Mechanics/NDE_CubeSat_v2/Board/COMPOUND_512.SLDPRT
Mechanics/NDE_CubeSat_v2/Board/COMPOUND_444.SLDPRT
Mechanics/NDE_CubeSat_v2/Board/COMPOUND_506.SLDPRT
Mechanics/NDE_CubeSat_v2/Board/COMPOUND_240.SLDPRT
Mechanics/NDE_CubeSat_v2/Board/COMPOUND_203.SLDPRT
Mechanics/NDE_CubeSat_v2/Board/COMPOUND_49.SLDPRT
Mechanics/NDE_CubeSat_v2/Board/COMPOUND_227.SLDPRT
Mechanics/NDE_CubeSat_v2/Board/COMPOUND_329.SLDPRT
Mechanics/NDE_CubeSat_v2/Board/COMPOUND_60.SLDPRT
Mechanics/NDE_CubeSat_v2/Board/COMPOUND_333.SLDPRT
Mechanics/NDE_CubeSat_v2/Board/SOLID_10.SLDPRT
Mechanics/NDE_CubeSat_v2/Board/COMPOUND_452.SLDPRT
Mechanics/NDE_CubeSat_v2/Board/COMPOUND_464.SLDPRT
Mechanics/NDE_CubeSat_v2/Board/COMPOUND_162.SLDPRT
Mechanics/NDE_CubeSat_v2/Board/COMPOUND_265.SLDPRT
Mechanics/NDE_CubeSat_v2/Board/COMPOUND_72.SLDPRT
Mechanics/NDE_CubeSat_v2/Board/COMPOUND_63.SLDPRT
Mechanics/NDE_CubeSat_v2/Board/132136-12.SLDASM
Mechanics/NDE_CubeSat_v2/Board/COMPOUND.SLDPRT
Mechanics/NDE_CubeSat_v2/Board/COMPOUND_10.SLDPRT
Mechanics/NDE_CubeSat_v2/Board/COMPOUND_100.SLDPRT
Mechanics/NDE_CubeSat_v2/Board/COMPOUND_102.SLDPRT
Mechanics/NDE_CubeSat_v2/Board/COMPOUND_103.SLDPRT
Mechanics/NDE_CubeSat_v2/Board/COMPOUND_104.SLDPRT
Mechanics/NDE_CubeSat_v2/Board/COMPOUND_105.SLDPRT
Mechanics/NDE_CubeSat_v2/Board/COMPOUND_106.SLDPRT
Mechanics/NDE_CubeSat_v2/Board/COMPOUND_107.SLDPRT
Mechanics/NDE_CubeSat_v2/Board/COMPOUND_108.SLDPRT
Mechanics/NDE_CubeSat_v2/Board/COMPOUND_109.SLDPRT
Mechanics/NDE_CubeSat_v2/Board/COMPOUND_11.SLDPRT
Mechanics/NDE_CubeSat_v2/Board/COMPOUND_110.SLDPRT
Mechanics/NDE_CubeSat_v2/Board/COMPOUND_112.SLDPRT
Mechanics/NDE_CubeSat_v2/Board/COMPOUND_113.SLDPRT
Mechanics/NDE_CubeSat_v2/Board/COMPOUND_114.SLDPRT
Mechanics/NDE_CubeSat_v2/Board/COMPOUND_115.SLDPRT
Mechanics/NDE_CubeSat_v2/Board/COMPOUND_116.SLDPRT
Mechanics/NDE_CubeSat_v2/Board/COMPOUND_117.SLDPRT
Mechanics/NDE_CubeSat_v2/Board/COMPOUND_118.SLDPRT
Mechanics/NDE_CubeSat_v2/Board/COMPOUND_119.SLDPRT
Mechanics/NDE_CubeSat_v2/Board/COMPOUND_12.SLDPRT
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
