marouncz/GraviGon/IMUnav_Gravi_Addon.pdf

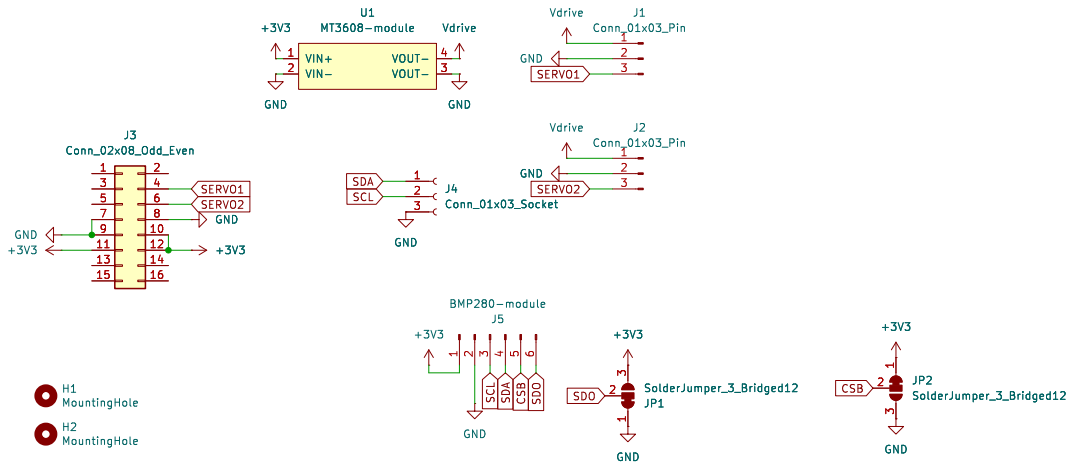
[picture p36: page 1]

Id: 1/1 Title: File: IMUnav_Gravi_Addon.kicad_sch Sheet: /
