marouncz/GraviGon/drawio/bmpTask.pdf

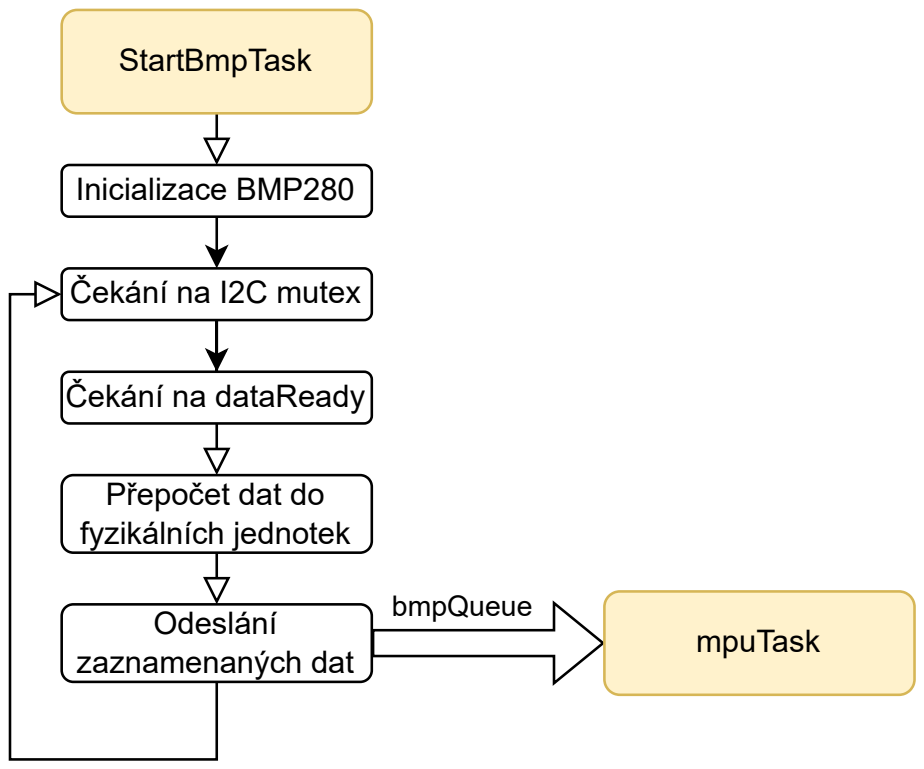
[picture p37: page 1]
StartBmpTask; Inicializace BMP280; bmpQueue Odeslání; zaznamenaných dat; mpuTask

Čekání na I2C mutex

Čekání na dataReady

Přepočet dat do
fyzikálních jednotek
