marouncz/GraviGon/drawio/IMUnav_H00_block.drawio.pdf

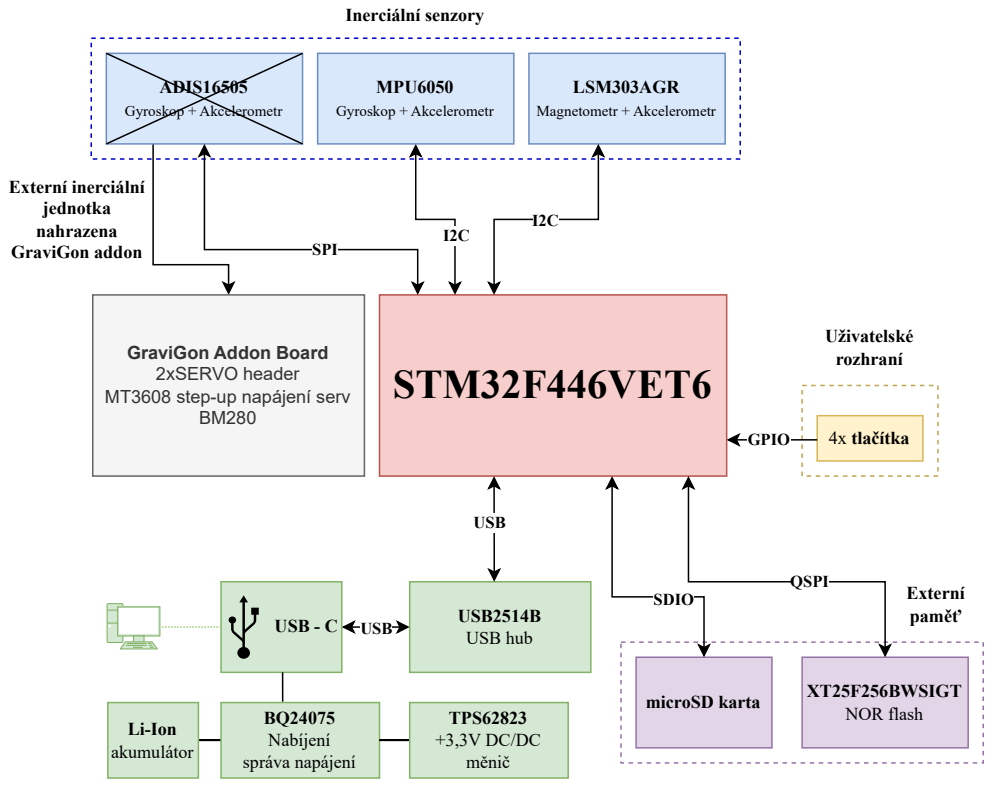
[picture p38: page 1]
STM32F446VET6; Inerciální senzory; ADIS16505 Gyroskop + Akcelerometr; MPU6050 Gyroskop + Akcelerometr; LSM303AGR Magnetometr + Akcelerometr; SPI; USB - C; USB2514B; USB; 4x tlačítka; Uživatelské rozhraní; GPIO; microSD karta; XT25F256BWSIGT; NOR flash; SDIO; QSPI; Externí; paměť; BQ24075 Nabíjení správa napájení; TPS62823 +3,3V DC/DC měnič; Li-Ion akumulátor; Externí inerciální jednotka nahrazena GraviGon addon

GraviGon Addon Board
2xSERVO header
MT3608 step-up napájení serv

USB hub USB
