marouncz/GraviGon/drawio/keepaliveTask.pdf

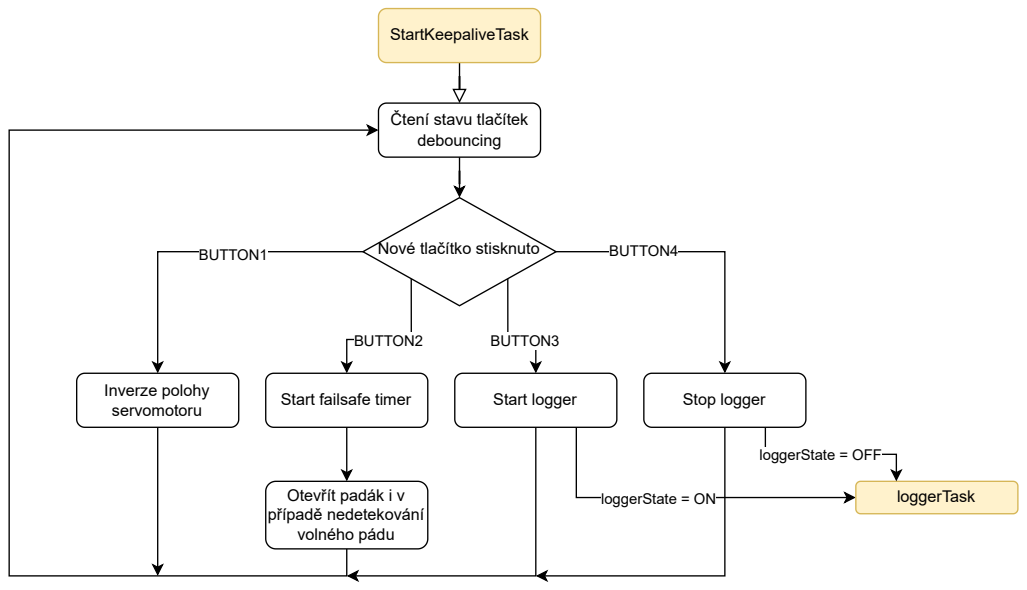
[picture p39: page 1]
StartKeepaliveTask; BUTTON1; BUTTON2; BUTTON3; Nové tlačítko stisknuto; BUTTON4; Inverze polohy; servomotoru; Start failsafe timer; Otevřít padák i v případě nedetekování volného pádu; loggerState = ON; Start logger; loggerTask; loggerState = OFF; Stop logger

Čtení stavu tlačítek
debouncing

# StartHubTask

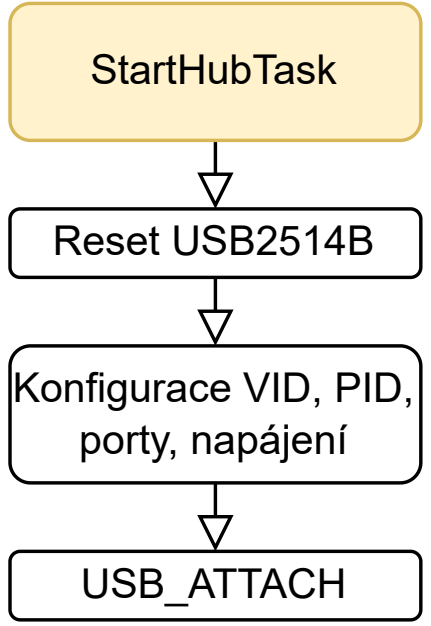
[picture p40: page 2]
Reset USB2514B; USB_ATTACH

Konfigurace VID, PID,
porty, napájení

### StartPowerTask

### Inicializace ADC DMA

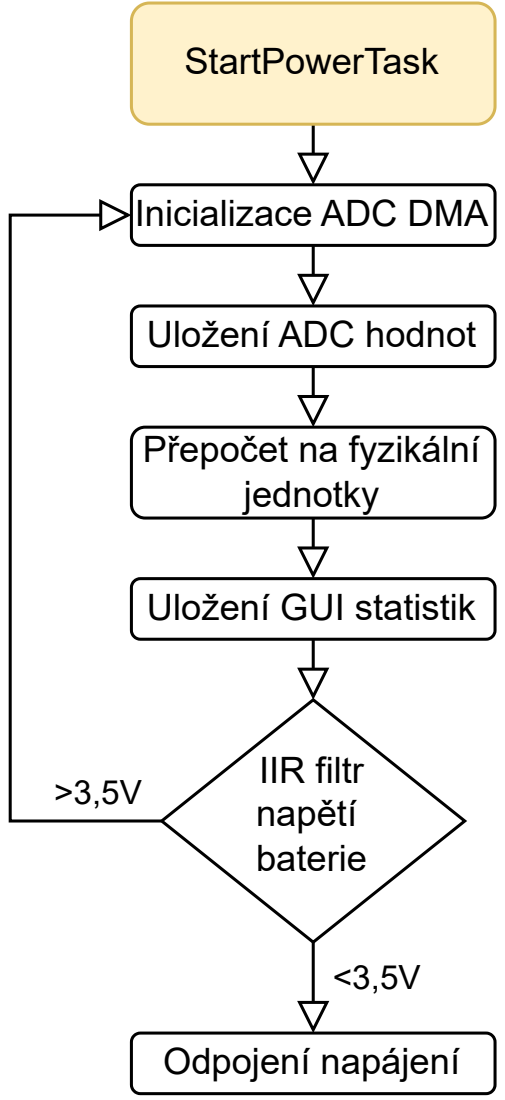
[picture p41: page 3]
IIR filtr napětí baterie; Odpojení napájení

Uložení ADC hodnot

Přepočet na fyzikální
jednotky

Uložení GUI statistik

## StartLsmTask

## Inicializace LSM303

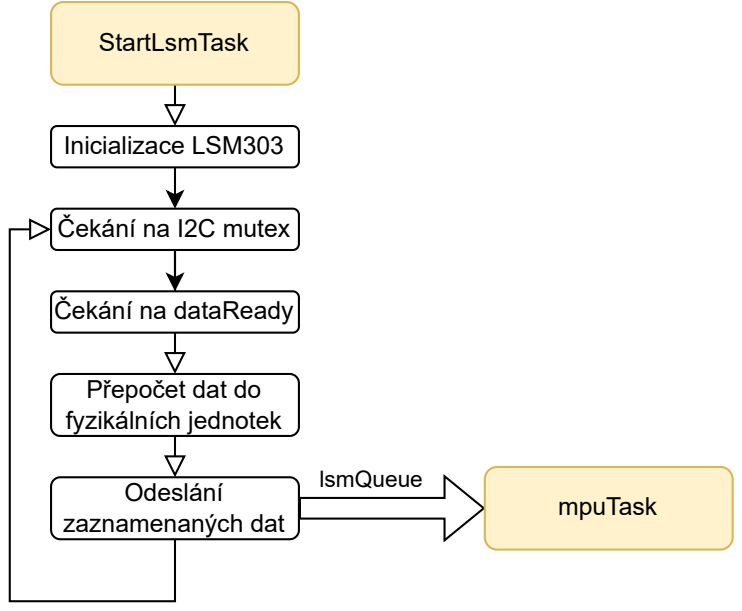
[picture p42: page 4]
lsmQueue Odeslání; zaznamenaných dat; mpuTask

Čekání na I2C mutex

Čekání na dataReady

Přepočet dat do
fyzikálních jednotek

## StartBmpTask

## Inicializace BMP280

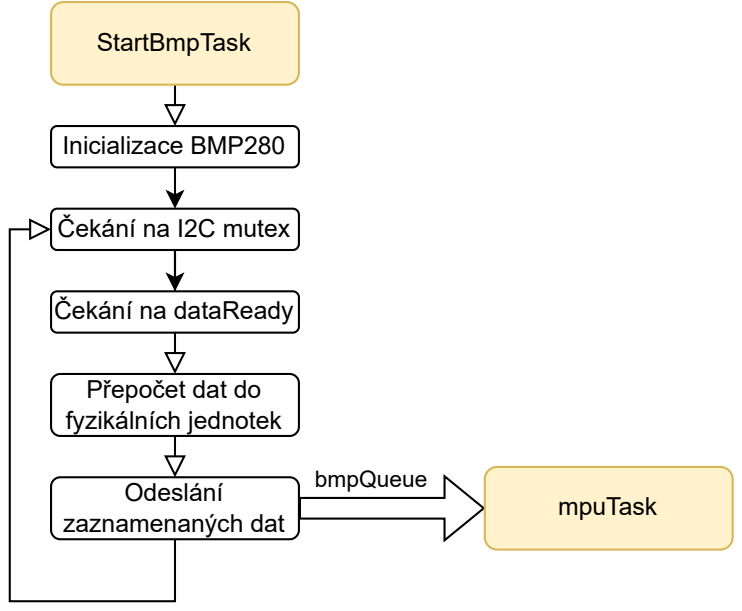
[picture p43: page 5]
bmpQueue Odeslání; zaznamenaných dat; mpuTask

Čekání na I2C mutex

Čekání na dataReady

Přepočet dat do
fyzikálních jednotek

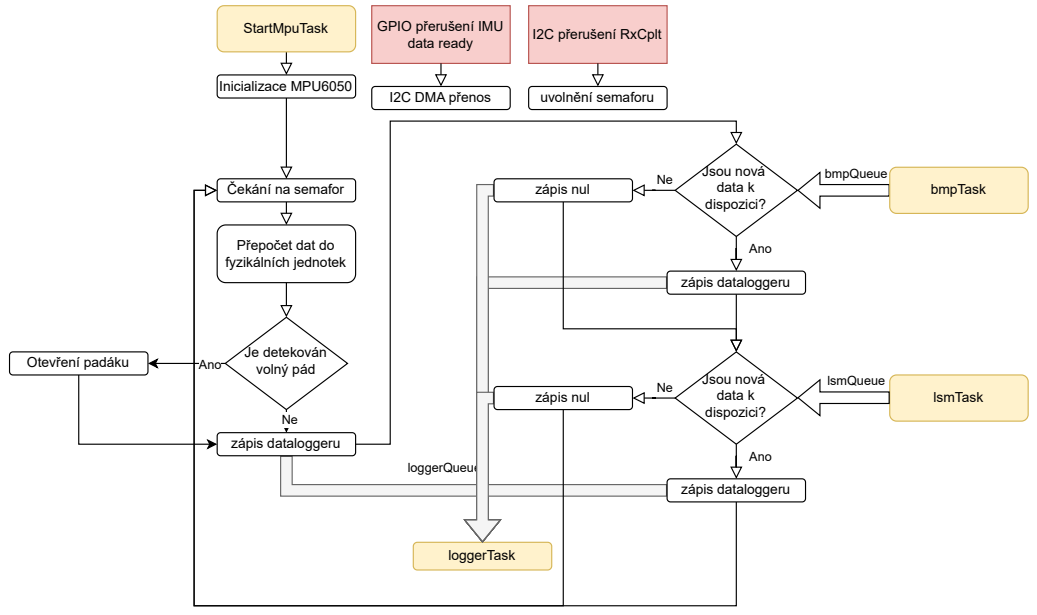
[picture p44: page 6]
StartMpuTask; Inicializace MPU6050; I2C DMA přenos; I2C přerušení RxCplt; uvolnění semaforu; bmpQueue; bmpTask; Ano; Jsou nová data k dispozici?; loggerQueue; zápis dataloggeru; loggerTask; zápis nul; lsmTask; lsmQueue; Je detekován

GPIO přerušení IMU
data ready

Čekání na semafor

Přepočet dat do
fyzikálních jednotek

volný pád Otevření padáku

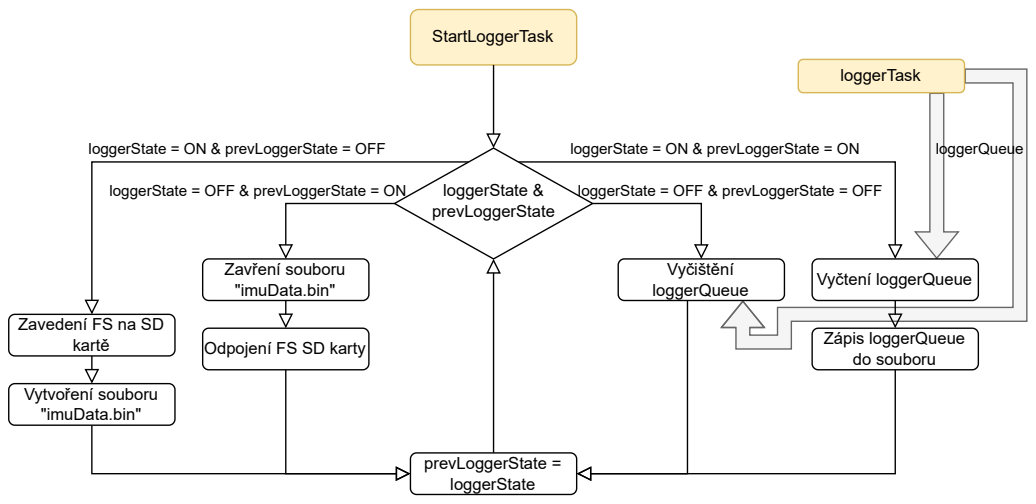
[picture p45: page 7]
StartLoggerTask; loggerState = OFF & prevLoggerState = ON; loggerState = OFF & prevLoggerState = OFF; loggerState & prevLoggerState; kartě; Vytvoření souboru "imuData.bin"; prevLoggerState = loggerState; Zavření souboru "imuData.bin"; loggerQueue; loggerTask; Vyčištění; Vyčtení loggerQueue; Zápis loggerQueue do souboru

loggerState = ON & prevLoggerState = OFF

loggerState = ON & prevLoggerState = ON

Zavedení FS na SD

Odpojení FS SD karty

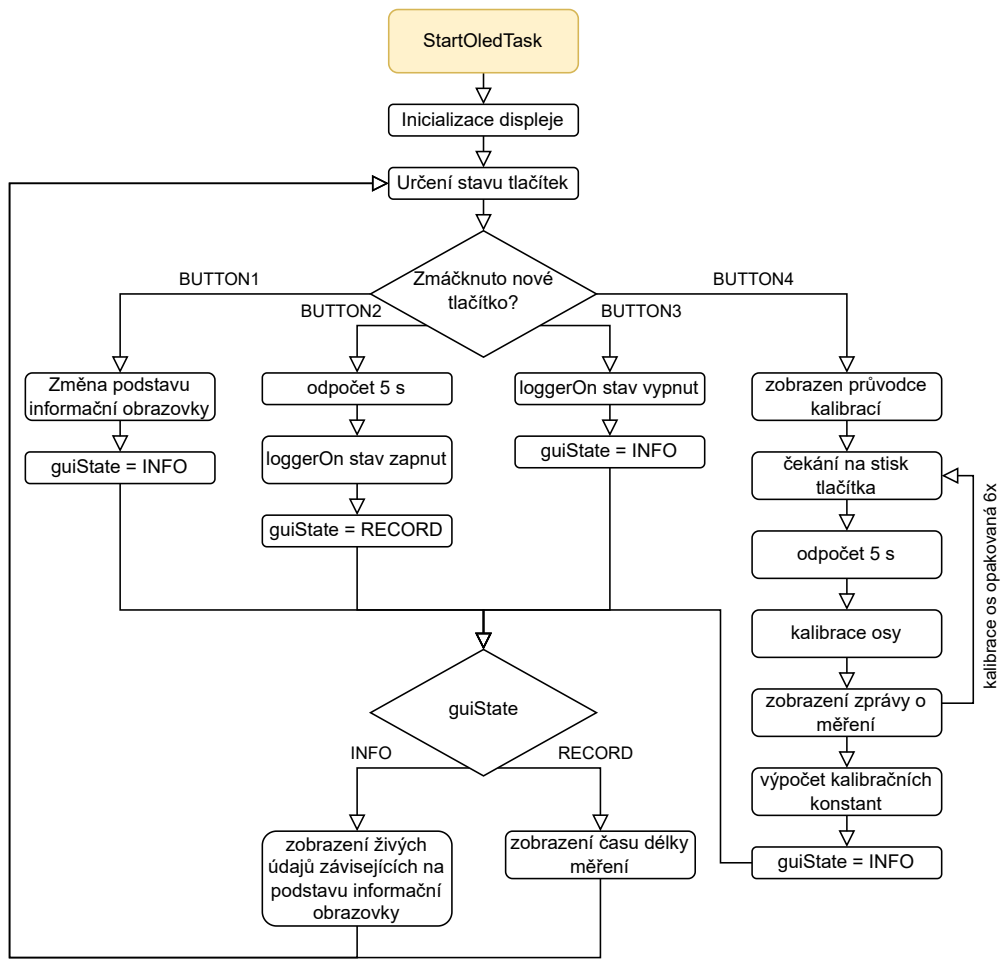
[picture p46: page 8]
StartOledTask; Inicializace displeje; BUTTON1; BUTTON2; BUTTON3; Zmáčknuto nové; BUTTON4; tlačítko?; Změna podstavu informační obrazovky; odpočet 5 s; loggerOn stav vypnut; zobrazen průvodce; kalibrací; kalibrace osy; zobrazení zprávy o měření; výpočet kalibračních konstant; guiState = INFO; guiState = RECORD; INFO; RECORD; guiState

Určení stavu tlačítek

loggerOn stav zapnut

čekání na stisk
tlačítka

kalibrace os opakovaná 6x

zobrazení živých
údajů závisejících na
podstavu informační
obrazovky

zobrazení času délky
měření
