marouncz/GraviGon/drawio/LoggerTask.pdf

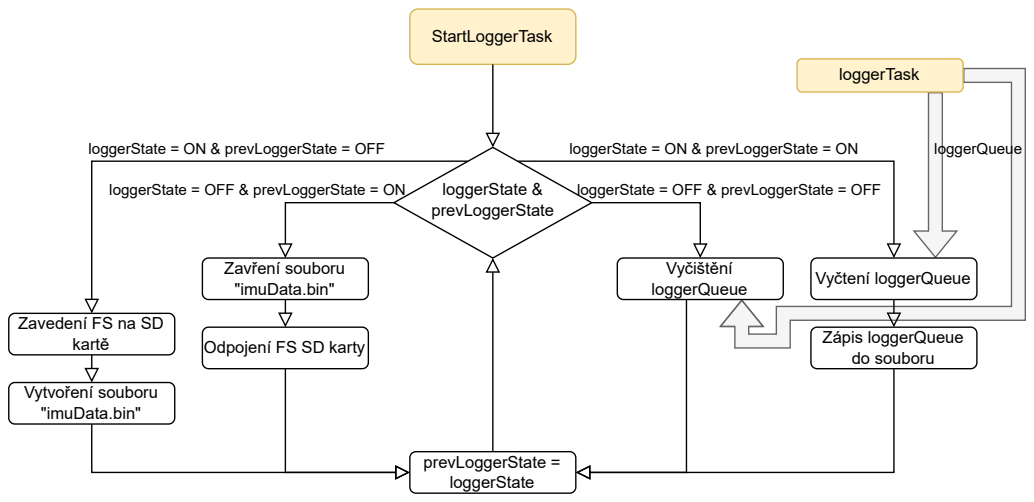
[picture p47: page 1]
StartLoggerTask; loggerState = OFF & prevLoggerState = ON; loggerState = OFF & prevLoggerState = OFF; loggerState & prevLoggerState; Vytvoření souboru "imuData.bin"; prevLoggerState = loggerState; Zavření souboru "imuData.bin"; loggerQueue; loggerTask; Vyčištění; Vyčtení loggerQueue; Zápis loggerQueue do souboru

loggerState = ON & prevLoggerState = OFF

loggerState = ON & prevLoggerState = ON

Zavedení FS na SD
kartě

Odpojení FS SD karty
