marouncz/GraviGon/drawio/PowerTask.pdf

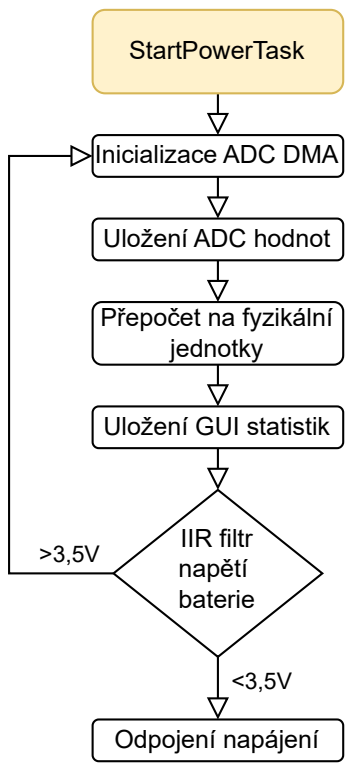
[picture p48: page 1]
StartPowerTask; IIR filtr napětí baterie; Odpojení napájení

Inicializace ADC DMA

Uložení ADC hodnot

Přepočet na fyzikální
jednotky

Uložení GUI statistik
