marouncz/GraviGon/graviB.pdf

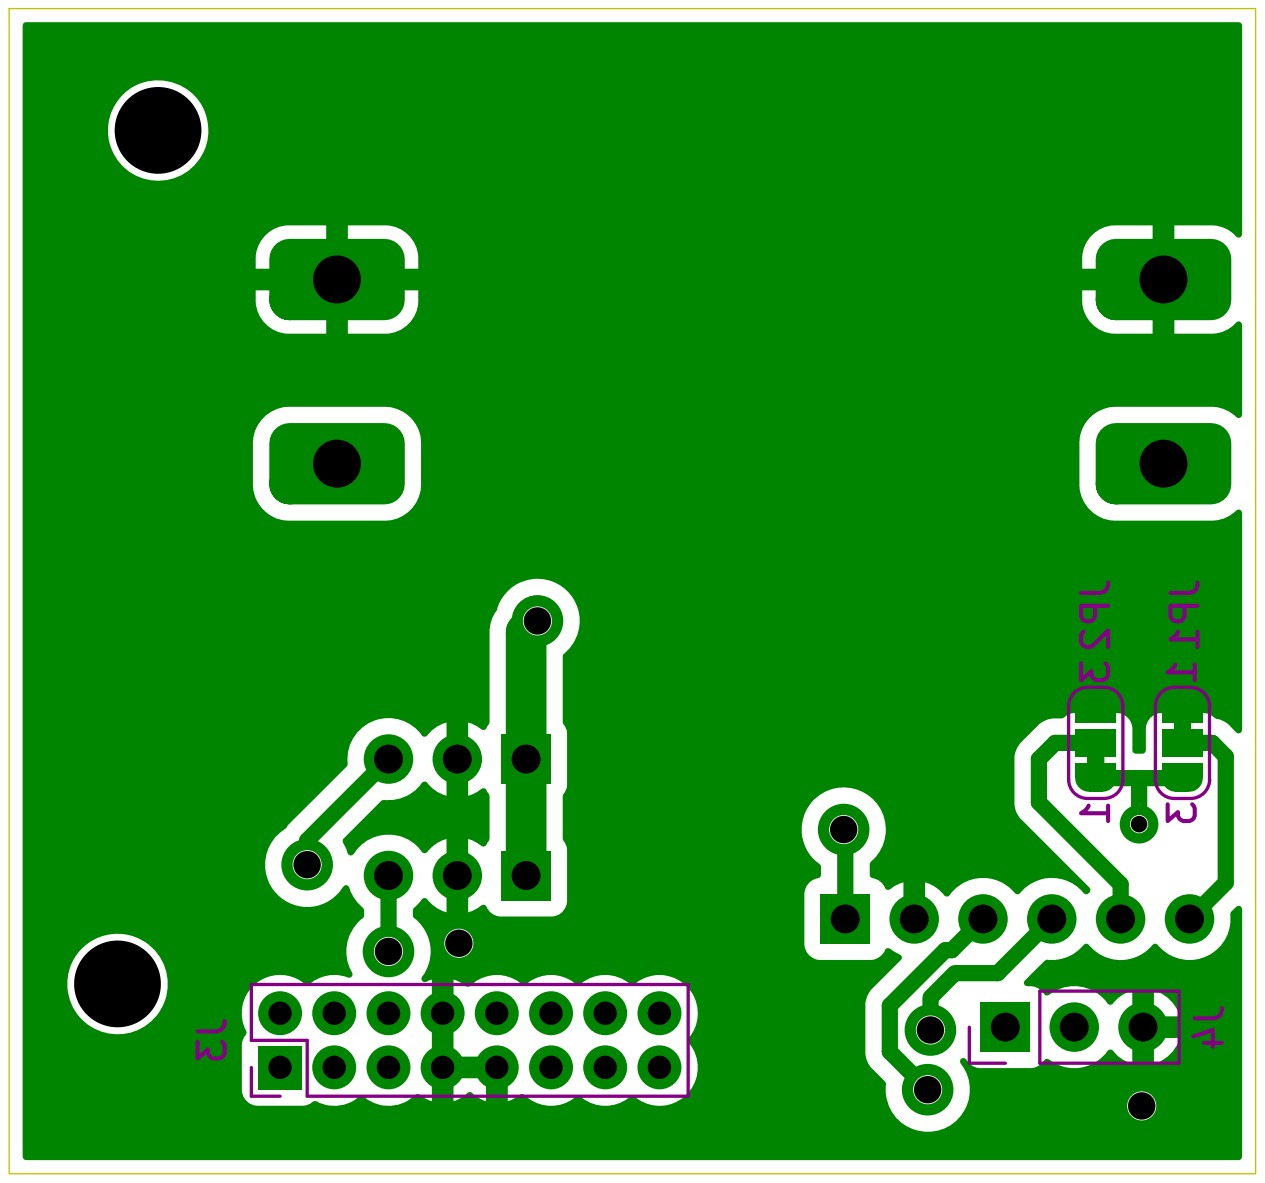
[picture p49: page 1]
