marouncz/GraviGon/graviF.pdf

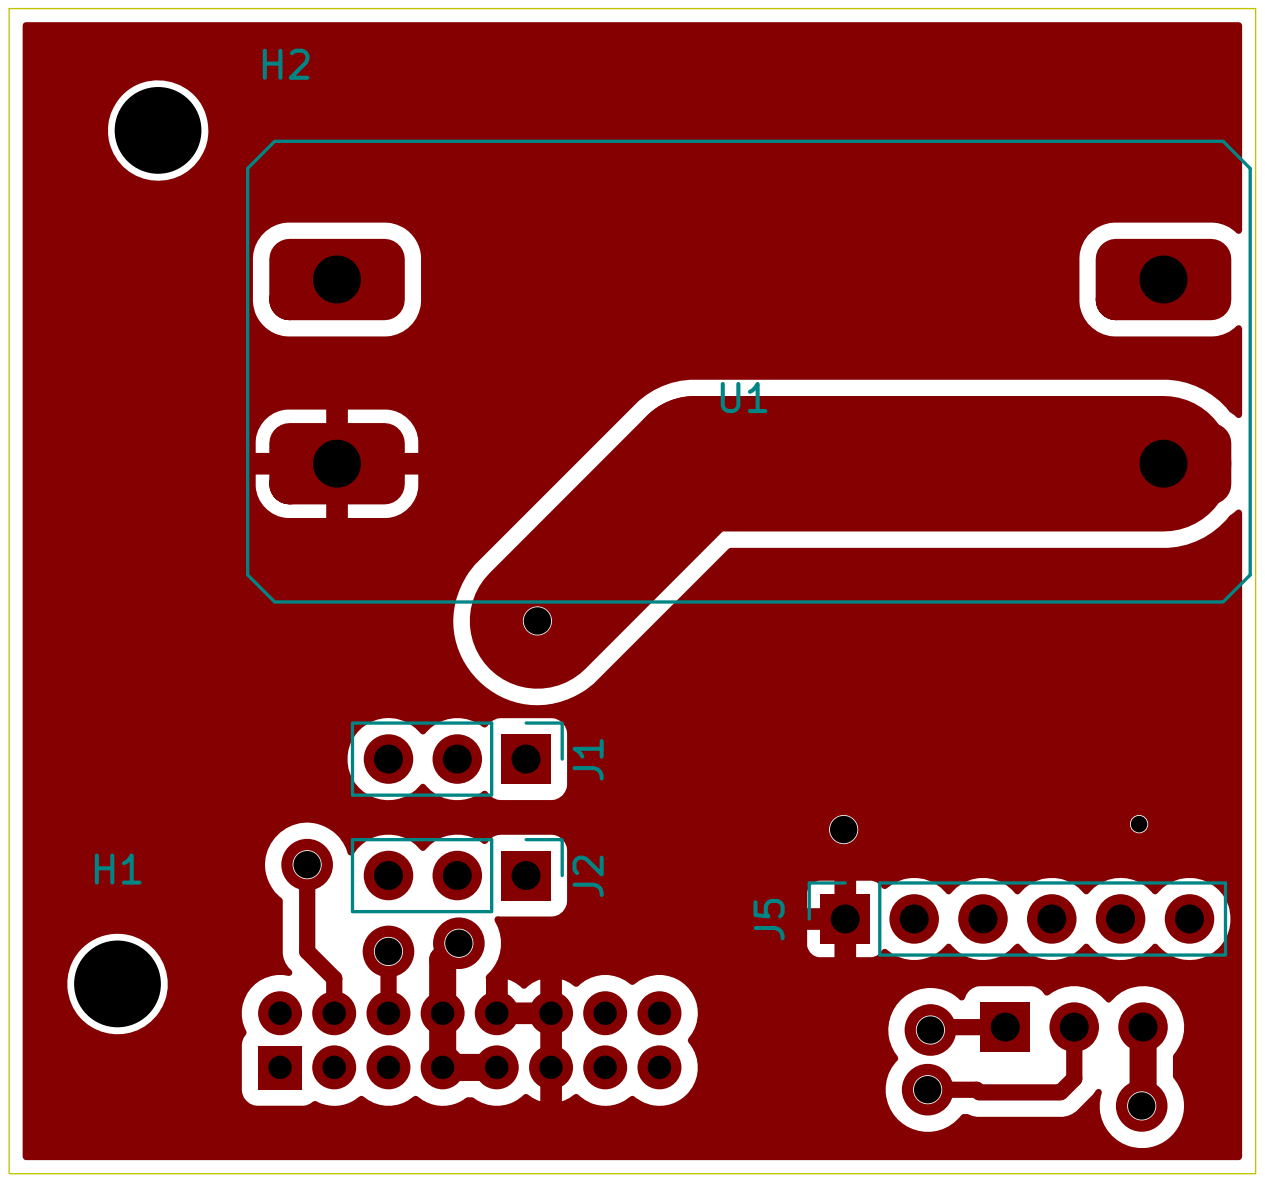
[picture p50: page 1]
