marouncz/GraviGon/Electronics/IMUnav_H00/IMUnav_H00.kicad_pcb

## KiCad design Electronics/IMUnav_H00/IMUnav_H00.kicad_pcb (2025-04-14)

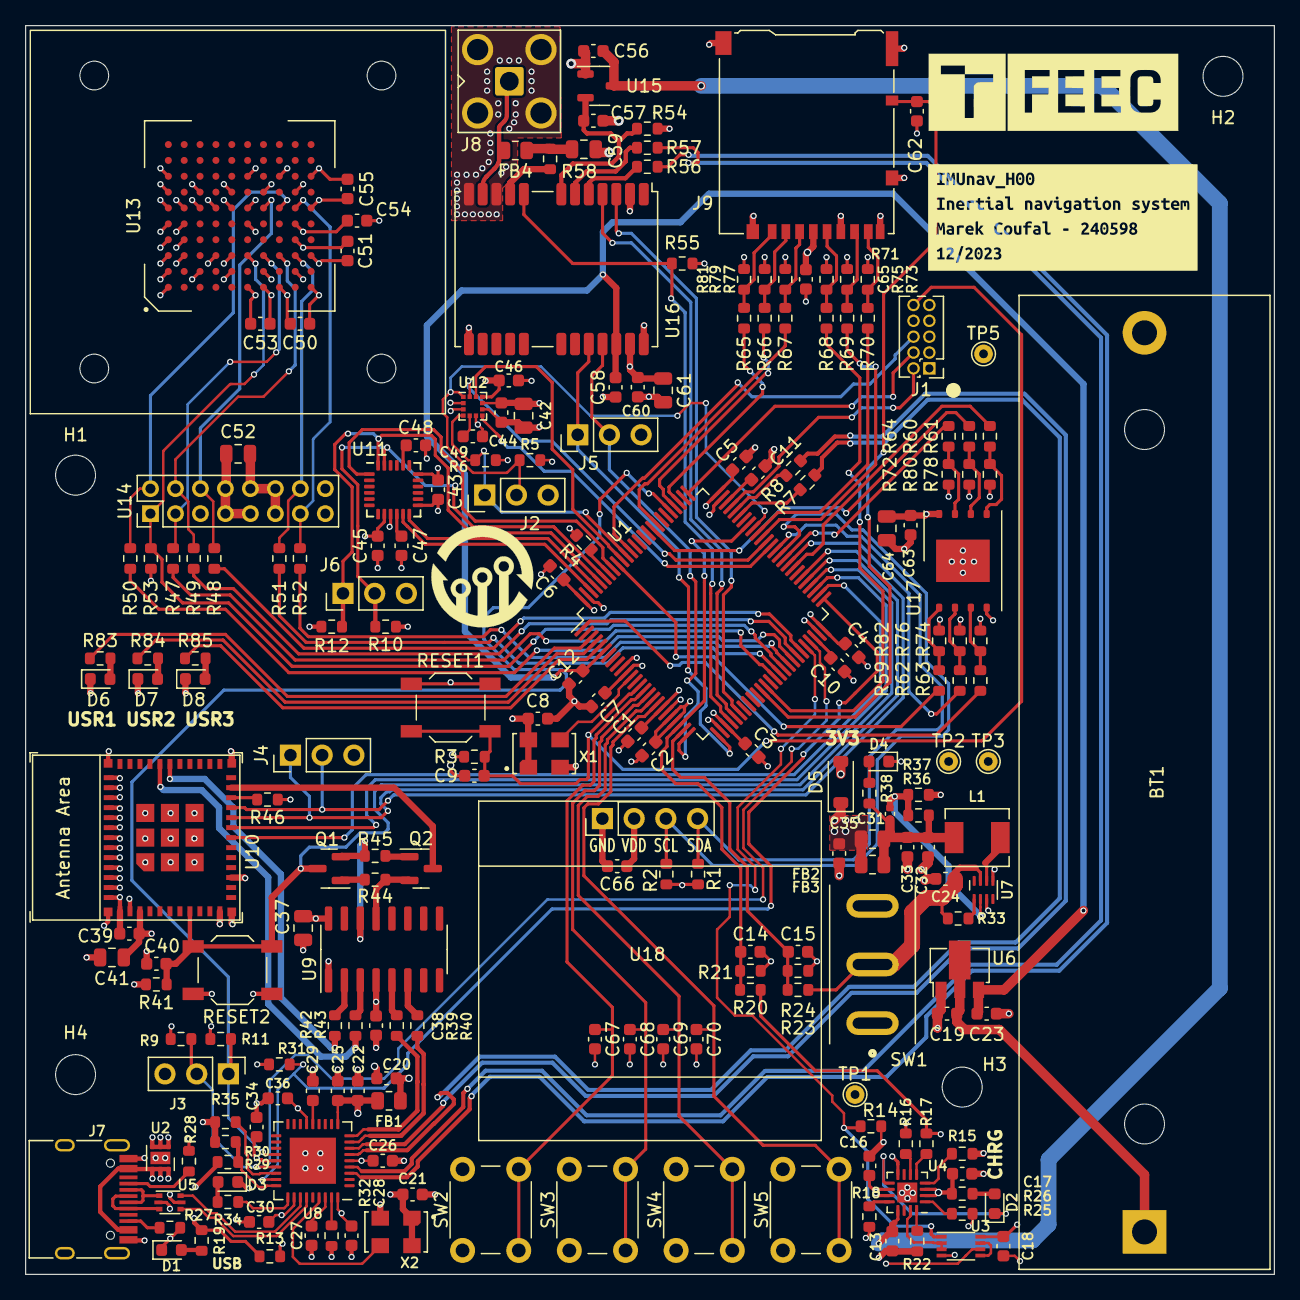
[picture p51: board IMUnav_H00.kicad_pcb from above]

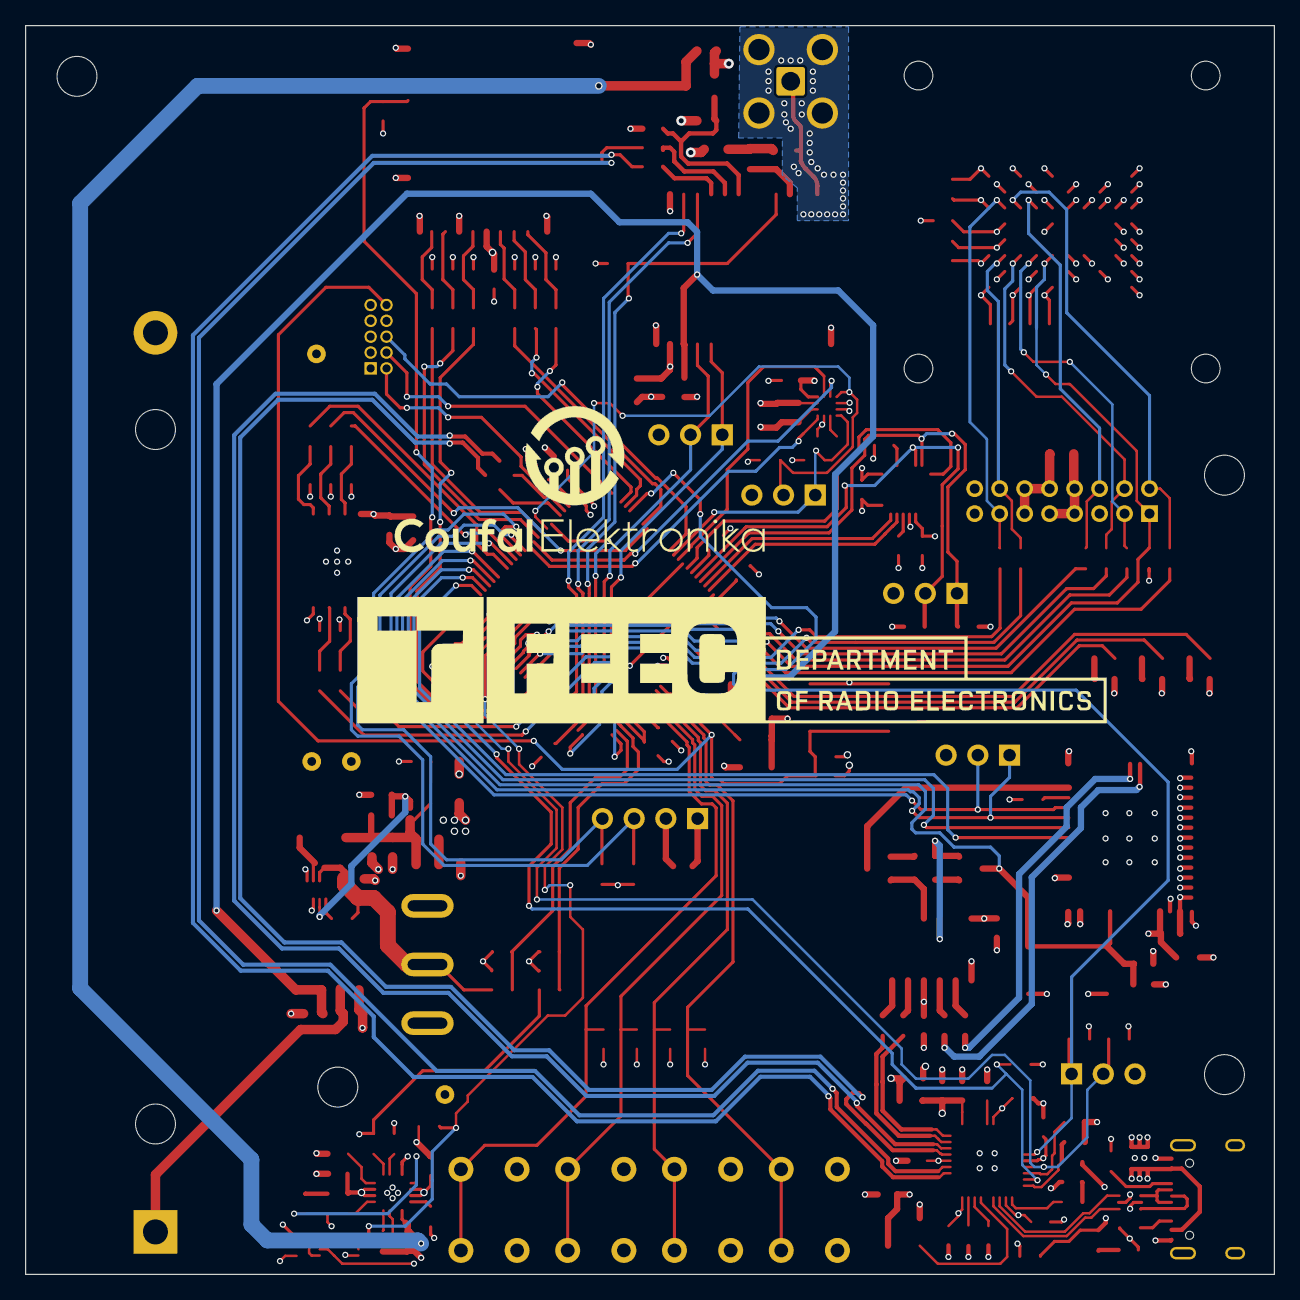
[picture p52: board IMUnav_H00.kicad_pcb from below]

Board: 4 copper layers, 100.0 x 100.0 mm, 220 parts (2 on the bottom side), 151 nets.

Parts:
BT1: Li-Ion 18650; BatteryHolder_MPD_BH-18650-PC2
C1, C2, C3, C4, C5, C6, C7, C8, C9, C12, C14, C15, C18, C21, C27, C29, C34, C36, C38, C39, C43, C44, C45, C46, C47, C50, C51, C53, C54, C55, C58, C60, C62, C63, C65, C66, C67, C68, C69, C70: 100n; C_0603_1608Metric
C10, C11: 2u2; C_0603_1608Metric
C13, C19, C23, C40, C56, C57: 1u; C_0603_1608Metric
C16, C17, C20, C22, C24: 4u7; C_0603_1608Metric
C25, C26, C28, C30: 10n; C_0603_1608Metric
C31: 1n; C_0402_1005Metric
C32, C33, C35: 22u; C_0603_1608Metric
C37, C41, C42, C52, C59, C61, C64: 10u; C_0805_2012Metric
C48: 2n2; C_0603_1608Metric
C49: 220n; C_0603_1608Metric
D1, D4: LED_GREEN; LED_0603_1608Metric
D2, D3: LED_RED; LED_0603_1608Metric
D5: B5819W; D_SOD-123
D6, D7, D8: LED_YELLOW; LED_0603_1608Metric
FB1, FB2, FB3, FB4: GZ2012D101TF; R_0805_2012Metric
G1: FEEC_logo
G2: FEEC_logo_long
G3: CoufalElektronika_logo; Coufal_elektronika_notext_10mm
G4: CoufalElektronika_logo; Coufal_elektronika_text_30x13mm
H1, H2, H3, H4: MountingHole; MountingHole_3.2mm_M3
J1: Conn_ARM_JTAG_SWD_10; PinHeader_2x05_P1.27mm_Vertical
J2, J3, J4, J5, J6: Conn_01x03_Pin; PinHeader_1x03_P2.54mm_Vertical
J7: 918-418K2023S40001; USB_C_Receptacle_HRO_TYPE-C-31-M-12
J8: SMA6252A2-3GT50G-50; SMA_Amphenol_901-143_Horizontal
J9: Micro_SD_Card_Det_Hirose_DM3AT; microSD_HC_Hirose_DM3AT-SF-PEJM5
L1: 470n; L_Chilisin_BMRA00040420
Q1, Q2: S8050; SOT-23
R1, R2, R3, R4, R5, R6, R9, R10, R11, R12, R16, R17, R23, R25, R41, R46, R71, R72, R73, R74, R75, R76, R77, R78, R79, R80, R81, R82: 10K; R_0603_1608Metric
R7, R8, R39, R40, R47, R48, R49, R50, R51, R52, R56, R57, R59, R60, R61, R62, R63, R64, R65, R66, R67, R68, R69, R70: 33R; R_0603_1608Metric
R13, R14, R15, R29, R30, R31, R33, R35, R53, R54, R55: 100K; R_0603_1608Metric
R18, R19, R22, R83, R84, R85: 1K8; R_0603_1608Metric
R20: 27K; R_0603_1608Metric
R21: 33K; R_0603_1608Metric
R24: 30K; R_0603_1608Metric
R26: 1K; R_0603_1608Metric
R27, R28: 5K1; R_0603_1608Metric
R32, R44, R45: 12K; R_0603_1608Metric
R34, R38, R42, R43: 470R; R_0603_1608Metric
R36: 68K; R_0603_1608Metric
R37: 15K; R_0603_1608Metric
R58: 10R; R_0603_1608Metric
RESET1, RESET2: SW_SPST; SW_SPST_TL3342
SW1: MT-102; TE_A101SYCQ04
SW2, SW3, SW4, SW5: SW_SPST; SW_PUSH_6mm_H13mm
TP1, TP2, TP3, TP5: TestPoint; TestPoint_THTPad_D1.5mm_Drill0.7mm
U1: STM32F446VETx; LQFP-100_14x14mm_P0.5mm
U2: TVS0500DRV; WSON-6-1EP_2x2mm_P0.65mm_EP1x1.6mm
U3: 74LVC2G02; VSSOP-8_2.3x2mm_P0.5mm
U4: BQ24075RGT; VQFN-16-1EP_3x3mm_P0.5mm_EP1.6x1.6mm
U5: USBLC6-2P6; SOT-666
U6: HT7533-1; SOT-89-3
U7: TPS62823DLC; Texas_VSON-HR-8_1.5x2mm_P0.5mm
U8: USB2514B-AEZC-TR; QFN-36-1EP_6x6mm_P0.5mm_EP3.7x3.7mm
U9: CH340G; SOIC-16_3.9x9.9mm_P1.27mm
U10: ESP32-C3-MINI-1
U11: MPU-6050; InvenSense_QFN-24_4x4mm_P0.5mm
U12: LSM303AGR; LGA-12_2x2mm_P0.5mm
U13: ADIS16505-2BMLZ; BGA-100_10x10_15.0x15.0mm
U14: ADIS16505-x/PCBZ; ADIS16505-PCBZ
U15: XC6206P332MR; SOT-23-3
U16: NEO-M8U; ublox_NEO
U17: XT25F256BWSIGT; WSON-8-1EP_8x6mm_P1.27mm_EP3.4x4.3mm
U18: OLED_I2C; Display_128x64_096_I2C
X1, X2: SX5M24.000M20F30TNN; OSC_ECS-3963-250-BN-TR
kibuzzard-656DA471: G***; kibuzzard-656DA471

Connections:
+3V3: C1.1, C2.1, C3.1, C4.1, C5.1, C6.1, C7.1, C8.1, C20.1, C21.1, C34.1, C35.1, C36.1, C37.1, C38.1, C39.1, C41.1, C42.1, C43.1, C44.1, C45.1, C46.1, C50.1, C51.1, C52.1, C53.1, C54.1, C55.1, C60.1, C61.1, C63.1, C64.1, C65.1, C66.1, D5.1 (K), FB1.1, FB2.2, FB3.2, J1.1 (VTref), J9.4 (VDD), R1.1, R2.1, R3.1, R5.1, R6.1, R9.1, R10.1, R11.1, R12.1, R31.1, R41.1, R46.1, R53.1, R55.1, R71.1, R72.1, R73.1, R74.1, R75.1, R76.1, R77.1, R78.1, R79.1, R80.1, R81.1, R82.1, TP3.1, U1.11 (VDD), U1.19 (VDD), U1.21 (VREF+), U1.22 (VDDA), U1.28 (VDD), U1.50 (VDD), U1.75 (VDD), U1.100 (VDD), U8.15 (VDD33), U8.23 (VDD33), U9.4 (V3), U9.16 (VCC), U10.3 (3V3), U11.8 (VDDIO), U11.13 (VDD), U12.2 (CS_XL), U12.3 (CS_MAG), U12.9 (VDD), U12.10 (VDDIO), U13.C7 (VDD), U13.D6 (VDD), U13.E3 (VDD), U13.G1 (VDD), U13.H1 (VDD), U13.J4 (VDD), U13.J5 (VDD), U13.K6 (VDD), U14.10 (VDD), U14.11 (VDD), U14.12 (VDD), U16.2 (D_SEL), U16.23 (VCC), U17.8 (VCC), U18.2 (VCC), X1.1 (Tri-State), X1.4 (Vcc), X2.1 (Tri-State), X2.4 (Vcc)
+5V: C13.1, C56.1, J7.A4 (VBUS), J7.A9 (VBUS), J7.B4 (VBUS), J7.B9 (VBUS), R13.1, R17.1, R19.1, R20.1, R29.1, U2.4 (IN), U2.5 (IN), U2.6 (IN), U3.6, U4.13 (IN), U5.5 (VBUS), U15.3 (VI)
+BATT: C24.1, R23.1, R33.1, SW1.2 (B), U7.7 (VIN)
/ESP32/ESP_D+: R39.1, U8.9 (USBDP_DN4/PRT_DIS_P4)
/ESP32/ESP_D-: R40.1, U8.8 (USBDM_DN4/PRT_DIS_M4)
/GPS/GPS_BCKP_POWER: C12.1, C23.1, C58.1, U1.6 (VBAT), U6.3 (VOUT), U16.22 (V_BCKP)
/GPS/GPS_D+: R57.1, U8.4 (USBDP_DN2/PRT_DIS_P2)
/GPS/GPS_D-: R56.1, U8.3 (USBDM_DN2/PRT_DIS_M2)
/USB+Power/+3V3USB: C22.1, C25.1, C26.1, C28.1, C30.1, FB1.2, U8.5 (VDDA33), U8.10 (VDDA33), U8.29 (VDDA33), U8.36 (VDDA33)
/USB+Power/D+: U5.4 (I/O2), U8.31 (USBDP_UP)
/USB+Power/D-: U5.6 (I/O1), U8.30 (USBDM_UP)
/USB+Power/USB3_D+: R8.2, U8.7 (USBDP_DN3/PRT_DIS_P3)
/USB+Power/USB3_D-: R7.2, U8.6 (USBDM_DN3/PRT_DIS_M3)
ADIS_DIN: R48.1, U1.45 (PE14)
ADIS_DOUT: R49.1, U1.44 (PE13)
ADIS_DR: R52.1, U1.42 (PE11)
ADIS_SCLK: R50.1, U1.43 (PE12)
ADIS_SYNC: R51.1, U1.40 (PE9)
ADIS_~CS: R47.1, U1.39 (PE8)
ADIS_~RST: R53.2, U1.41 (PE10), U13.F3 (~RST), U14.1 (~RST)
BATT_VOLTAGE: C15.1, R23.2, R24.1, U1.24 (PA1)
BUTTON1: C67.1, SW2.2 (B), U1.15 (PC0)
BUTTON2: C68.1, SW3.2 (B), U1.16 (PC1)
BUTTON3: C69.1, SW4.2 (B), U1.17 (PC2)
BUTTON4: C70.1, SW5.2 (B), U1.18 (PC3)
ESP_CTS1: U1.53 (PB14), U10.19 (GPIO5/ADC2_CH0)
ESP_RST: C40.2, Q1.3 (C), R41.2, RESET2.2 (B), U1.54 (PB15), U10.8 (EN/CHIP_PU)
ESP_RTS1: U1.52 (PB13), U10.18 (GPIO4/ADC1_CH4)
ESP_RX1: J4.1, U1.55 (PD8), U10.20 (GPIO6)
ESP_TX1: J4.2, U1.56 (PD9), U10.21 (GPIO7)
GND: BT1.2 (-), C1.2, C2.2, C3.2, C4.2, C5.2, C6.2, C7.2, C8.2, C9.2, C10.2, C11.2, C12.2, C13.2, C14.2, C15.2, C16.2, C17.2, C18.2, C19.2, C20.2, C21.2, C22.2, C23.2, C24.2, C25.2, C26.2, C27.2, C28.2, C29.2, C30.2, C32.2, C33.2, C34.2, C35.2, C36.2, C37.2, C38.2, C39.2, C40.1, C41.2, C42.2, C43.2, C44.2, C45.2, C46.2, C47.2, C48.2, C49.2, C50.2, C51.2, C52.2, C53.2, C54.2, C55.2, C56.2, C57.2, C58.2, C59.2, C60.2, C61.2, C62.2, C63.2, C64.2, C65.2, C66.2, C67.2, C68.2, C69.2, C70.2, D1.1 (K), D3.1 (K), D4.1 (K), D5.2 (A), D6.1 (K), D7.1 (K), D8.1 (K), J1.3 (GND), J1.5 (GND), J1.9 (GNDDetect), J2.3, J3.3, J4.3, J5.3, J6.3, J7.A1 (GND), J7.A12 (GND), J7.B1 (GND), J7.B12 (GND), J8.2 (Ext), J9.6 (VSS), J9.9 (DET_B), J9.11 (SHIELD), R4.2, R13.2, R14.2, R15.2, R16.2, R18.2, R21.2, R22.2, R24.2, R25.2, R27.2, R28.2, R30.2, R32.2, R35.2, R37.2, R54.2, RESET1.1 (A), RESET2.1 (A), SW2.1 (A), SW3.1 (A), SW4.1 (A), SW5.1 (A), TP2.1, TP5.1, U1.10 (VSS), U1.20 (VSSA), U1.27 (VSS), U1.49 (VSS), U1.74 (VSS), U1.99 (VSS), U2.1 (GND), U2.2 (GND), U2.3 (GND), U2.7 (GND), U3.4 (GND), U4.8 (VSS), U4.17 (VSS), U5.2 (GND), U6.1 (GND), U7.3 (AGND), U7.5 (PGND), U8.37 (VSS), U9.1 (GND), U10.1 (GND), U10.2 (GND), U10.11 (GND), U10.14 (GND), U10.36 (GND), U10.37 (GND), U10.38 (GND), U10.39 (GND), U10.40 (GND), U10.41 (GND), U10.42 (GND), U10.43 (GND), U10.44 (GND), U10.45 (GND), U10.46 (GND), U10.47 (GND), U10.48 (GND), U10.49 (GND), U10.50 (GND), U10.51 (GND), U10.52 (GND), U10.53 (GND), U11.9 (AD0), U11.18 (GND), U12.6 (GND), U12.8 (GND), U13.A1 (GND), U13.A2 (GND), U13.A3 (GND), U13.A4 (GND), U13.A5 (GND), U13.A6 (GND), U13.A7 (GND), U13.A8 (GND), U13.B3 (GND), U13.B4 (GND), U13.B5 (GND), U13.B6 (GND), U13.C2 (GND), U13.C6 (GND), U13.D3 (GND), U13.E2 (GND), U13.E6 (GND), U13.E7 (GND), U13.F1 (GND), U13.F5 (GND), U13.F6 (GND), U13.F8 (GND), U13.G2 (GND), U13.G7 (GND), U13.H8 (GND), U13.J2 (GND), U13.J7 (GND), U13.K1 (GND), U13.K3 (GND), U13.K8 (GND), U14.7 (GND), U14.8 (GND), U14.9 (GND), U15.1 (GND), U16.10 (GND), U16.12 (GND), U16.13 (GND), U16.24 (GND), U17.4 (GND), U17.9 (EP), U18.1 (GND), X1.2 (GND), X2.2 (GND)
GPS_EXTINT: U1.30 (PA5), U16.4 (EXTINT)
GPS_RX: J5.2, U1.25 (PA2), U16.21 (RXD/SPI_MOSI)
GPS_TIMEPULSE: U1.31 (PA6), U16.3 (TIMEPULSE)
GPS_TX: J5.1, U1.26 (PA3), U16.20 (TXD/SPI_MISO)
GPS_~RESET: R55.2, U1.29 (PA4), U16.8 (~RESET)
HUB_SCL: J3.2, R9.2, U1.47 (PB10), U8.24 (SCL/SMBCLK/CFG_SEL0)
HUB_SDA: J3.1, R11.2, U1.80 (PC12), U8.22 (SDA/SMBDATA/NON_REM1)
HUB_~RESET: R31.2, U1.51 (PB12), U8.26 (RESET_N)
LED1: R83.1, U1.3 (PE4)
LED2: R84.1, U1.4 (PE5)
LED3: R85.1, U1.5 (PE6)
LSM_INT1ACCL: U1.64 (PC7), U12.12 (INT_1_XL)
LSM_INT2ACCL: U1.91 (PB5), U12.11 (INT_2_XL)
LSM_INTMAG: U1.63 (PC6), U12.7 (INT_MAG/DRDY)
LSM_SCL: J2.2, R5.2, U1.67 (PA8), U12.1 (SCL/SPC)
LSM_SDA: J2.1, R6.2, U1.90 (PB4), U12.4 (SDA/SDI/SDO)
MPU_CLKIN: U1.93 (PB7), U11.1 (CLKIN)
MPU_FSYNC: U1.98 (PE1), U11.11 (FSYNC)
MPU_INT: U1.97 (PE0), U11.12 (INT)
MPU_SCL: J6.2, R10.2, U1.95 (PB8), U11.23 (SCL)
MPU_SDA: J6.1, R12.2, U1.96 (PB9), U11.24 (SDA)
unnamed: BT1.1 (+), C17.1, C18.1, C19.1, R26.1, U3.8 (VCC), U4.2 (BAT), U4.3 (BAT), U6.2 (VIN)
unnamed: C31.1, C32.1, C33.1, FB2.1, FB3.1, L1.2, R36.2, R38.2
unnamed: C59.1, FB4.1, R58.2
unnamed: D1.2 (A), R19.2
unnamed: D2.2 (A), R26.2
unnamed: D2.1 (K), U4.9 (~CHG)
unnamed: D3.2 (A), R34.2
unnamed: D4.2 (A), R38.1
unnamed: D6.2 (A), R83.2
unnamed: D7.2 (A), R84.2
unnamed: D8.2 (A), R85.2
unnamed: J7.A5 (CC1), R28.1
unnamed: J7.B5 (CC2), R27.1
unnamed: J7.A6 (D+), J7.B6 (D+), U5.3 (I/O2)
unnamed: J7.A7 (D-), J7.B7 (D-), U5.1 (I/O1)
unnamed: FB4.2, J8.1 (In), U16.11 (RF_IN)
unnamed: J9.5 (CLK), R68.2, R75.2
unnamed: J9.3 (CMD), R67.2, R77.2
unnamed: J9.7 (DAT0), R69.2, R73.2
unnamed: J9.8 (DAT1), R70.2, R71.2
unnamed: J9.1 (DAT2), R65.2, R81.2
unnamed: J9.2 (DAT3/CD), R66.2, R79.2
unnamed: Q1.1 (B), R44.1
unnamed: Q1.2 (E), R45.2, U9.14 (~RTS)
unnamed: Q2.1 (B), R45.1
unnamed: Q2.3 (C), U10.23 (GPIO9)
unnamed: Q2.2 (E), R44.2, U9.13 (~DTR)
unnamed: C16.1, SW1.1 (A), TP1.1, U4.10 (OUT), U4.11 (OUT)
unnamed: R4.1, U1.94 (BOOT0)
unnamed: U1.12 (PH0), X1.3 (OUT)
unnamed: C10.1, U1.48 (VCAP_1)
unnamed: C11.1, U1.73 (VCAP_2)
unnamed: U3.5, U3.7
unnamed: R16.1, U4.6 (EN1)
unnamed: R17.2, U4.5 (EN2)
unnamed: R18.1, U4.12 (ILIM)
unnamed: R22.1, U4.16 (ISET)
unnamed: U3.2, U3.3, U4.15 (SYSOFF)
unnamed: R25.1, U4.1 (TS)
unnamed: R15.1, U4.4 (~CE)
unnamed: R33.2, U7.1 (EN)
unnamed: C31.2, R36.1, R37.1, U7.2 (FB)
unnamed: L1.1, U7.6 (SW)
unnamed: C29.1, U8.14 (CRFILT)
unnamed: R35.1, U8.25 (HS_IND/CFG_SEL1)
unnamed: C27.1, U8.34 (PLLFILT)
unnamed: R32.1, U8.35 (RBIAS)
unnamed: R34.1, U8.28 (SUSP_IND/LOCAL_PWR/NON_REM0)
unnamed: R29.2, R30.1, U8.27 (VBUS_DET)
unnamed: U8.33 (XTALIN/CLKIN), X2.3 (OUT)
unnamed: R43.2, U9.3 (RXD)
unnamed: R42.2, U9.2 (TXD)
unnamed: R39.2, U9.5 (UD+)
unnamed: R40.2, U9.6 (UD-)
unnamed: R46.2, U10.22 (GPIO8)
unnamed: R42.1, U10.30 (GPIO20/U0RXD)
unnamed: R43.1, U10.31 (GPIO21/U0TXD)
unnamed: C48.1, U11.20 (CPOUT)
unnamed: C47.1, U11.10 (REGOUT)
unnamed: C49.1, U12.5 (C1)
unnamed: R48.2, U13.G6 (DIN), U14.6 (DIN)
unnamed: R49.2, U13.H3 (DOUT), U14.4 (DOUT)
unnamed: R52.2, U13.J6 (DR), U14.13 (DR)
unnamed: R50.2, U13.H6 (SCLK), U14.2 (SCLK)
unnamed: R51.2, U13.J3 (SYNC), U14.14 (SYNC)
unnamed: R47.2, U13.G3 (~CS), U14.3 (~CS)
unnamed: C57.1, R54.1, U15.2 (VO), U16.7 (VDD_USB)
unnamed: R56.2, U16.5 (USB_DM)
unnamed: R57.2, U16.6 (USB_DP)
unnamed: R58.1, U16.9 (VCC_RF)
unnamed: R60.2, R80.2, U17.6 (SCLK)
unnamed: R61.2, R78.2, U17.5 (SI/SIO0)
unnamed: R62.2, R76.2, U17.2 (SO/SIO1)
unnamed: R59.2, R82.2, U17.1 (~CS)
unnamed: R64.2, R72.2, U17.7 (~HOLD/SIO3)
unnamed: R63.2, R74.2, U17.3 (~WP/SIO2)
OLED_SCL: R2.2, U1.61 (PD14), U18.3 (SCL)
OLED_SDA: R1.2, U1.62 (PD15), U18.4 (SDA)
PWR_OFF: R14.1, U1.46 (PE15), U3.1
QSPI_IO0: R61.1, U1.58 (PD11)
QSPI_IO1: R62.1, U1.59 (PD12)
QSPI_IO2: R63.1, U1.1 (PE2)
QSPI_IO3: R64.1, U1.60 (PD13)
QSPI_SCLK: R60.1, U1.84 (PD3)
QSPI_~CS: R59.1, U1.92 (PB6)
SD_CARDSW: C62.1, J9.10 (DET_A), U1.36 (PB1)
SD_CLK: R68.1, U1.37 (PB2)
SD_CMD: R67.1, U1.83 (PD2)
SD_DAT0: R69.1, U1.65 (PC8)
SD_DAT1: R70.1, U1.66 (PC9)
SD_DAT2: R65.1, U1.78 (PC10)
SD_DAT3: R66.1, U1.79 (PC11)
STM_D+: R8.1, U1.71 (PA12)
STM_D-: R7.1, U1.70 (PA11)
SWD_CLK: J1.4 (SWCLK/TCK), U1.76 (PA14)
SWD_NRST: C9.1, J1.10 (~RESET), R3.2, RESET1.2 (B), U1.14 (NRST)
SWD_SWIO: J1.2 (SWDIO/TMS), U1.72 (PA13)
SWD_SWO: J1.6 (SWO/TDO), U1.89 (PB3)
USB_VOLTAGE: C14.1, R20.2, R21.1, U1.23 (PA0), U1.68 (PA9)
