marouncz/GraviGon/Electronics/IMUnav_Gravi_Addon/IMUnav_Gravi_Addon.kicad_pcb

## KiCad design Electronics/IMUnav_Gravi_Addon/IMUnav_Gravi_Addon.kicad_pcb (2025-03-02)

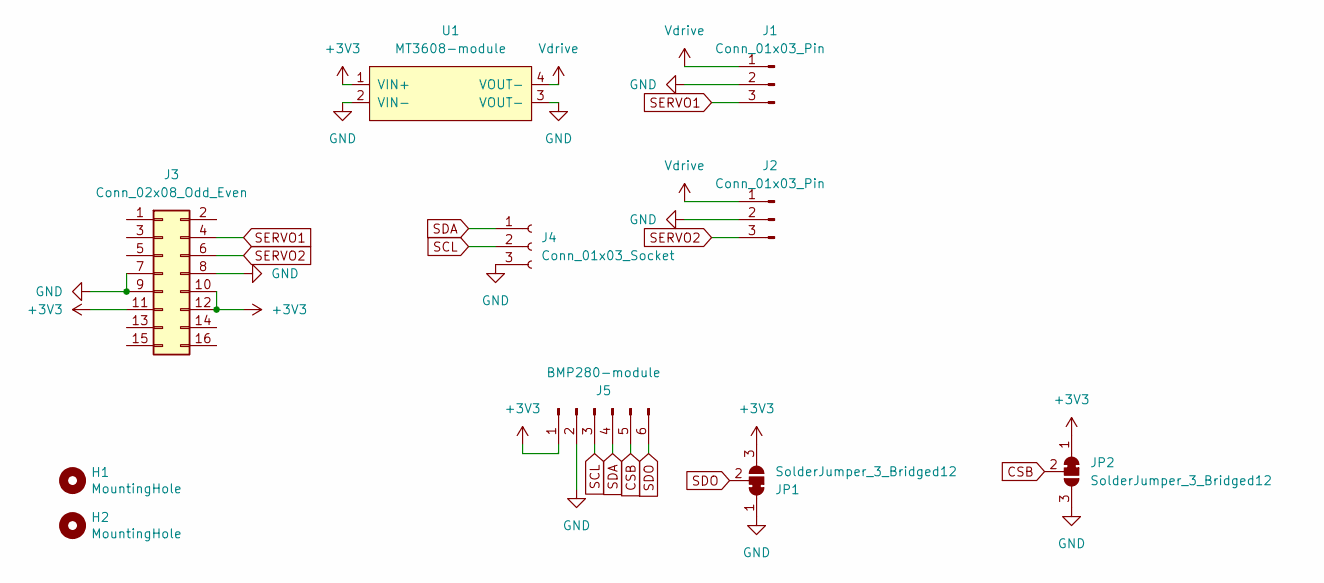
[picture p53: schematic IMUnav_Gravi_Addon.kicad_sch]

Parts:
H1, H2: MountingHole; MountingHole_3.2mm_M3
J1, J2: Conn_01x03_Pin; PinHeader_1x03_P2.54mm_Vertical
J3: Conn_02x08_Odd_Even; PinSocket_2x08_P2.00mm_Vertical
J4: Conn_01x03_Socket; PinSocket_1x03_P2.54mm_Vertical
J5: BMP280-module; PinSocket_1x06_P2.54mm_Vertical
JP1, JP2: SolderJumper_3_Bridged12; SolderJumper-3_P1.3mm_Bridged12_RoundedPad1.0x1.5mm_NumberL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
U1: MT3608-module; hw-045

Connections:
+3V3: J3.10, J3.11, J3.12, J5.1, JP1.3 (B), JP2.1 (A), U1.1 (VIN+)
CSB: J5.5, JP2.2 (C)
GND: J1.2, J2.2, J3.7, J3.8, J3.9, J4.3, J5.2, JP1.1 (A), JP2.3 (B), U1.2 (VIN-), U1.3 (VOUT-)
SCL: J4.2, J5.3
SDA: J4.1, J5.4
SDO: J5.6, JP1.2 (C)
SERVO1: J1.3, J3.4
SERVO2: J2.3, J3.6
Vdrive: J1.1, J2.1, U1.4 (VOUT-)

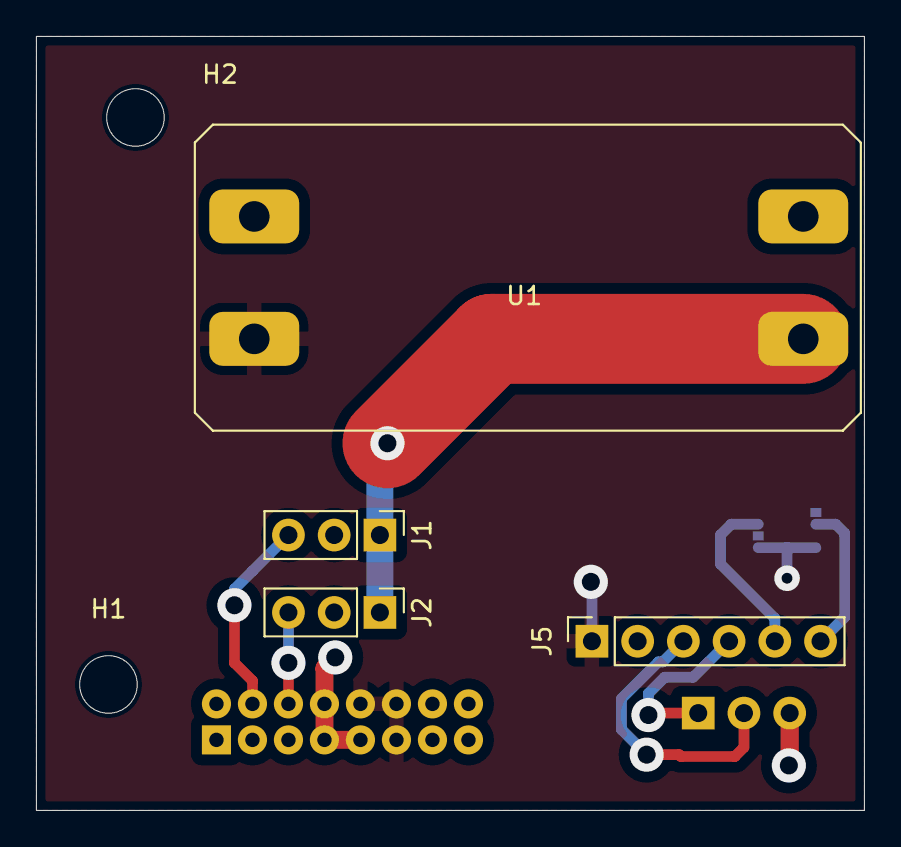
[picture p54: board IMUnav_Gravi_Addon.kicad_pcb from above]

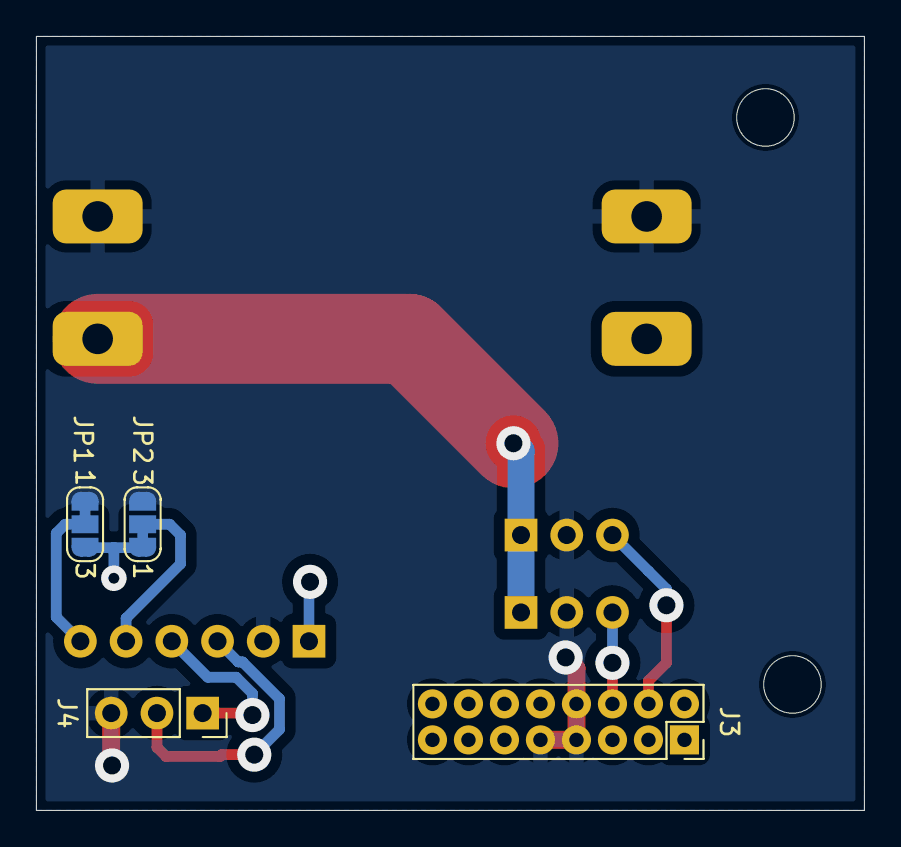
[picture p55: board IMUnav_Gravi_Addon.kicad_pcb from below]

Board: 2 copper layers, 46.0 x 43.0 mm, 10 parts (4 on the bottom side), 9 nets.
