marouncz/GraviGon/Software/GraviGon_F00/GraviGon_F00.ioc

Mcu.UserName=STM32F446VETx
PA0-WKUP.GPIO_Label=USB_VOLTAGE_ADC
PA0-WKUP.Signal=ADCx_IN0
PA1.GPIO_Label=BATT_VOLTAGE
PA1.Signal=ADCx_IN1
PA11.Signal=USB_OTG_FS_DM
PA12.Signal=USB_OTG_FS_DP
PA13.Signal=SYS_JTMS-SWDIO
PA14.Signal=SYS_JTCK-SWCLK
PA2.GPIO_Label=GPS_RX
PA2.Signal=USART2_TX
PA3.GPIO_Label=GPS_TX
PA3.Signal=USART2_RX
PA4.GPIO_Label=GPS_RST
PA4.Signal=GPIO_Output
PA8.Signal=I2C3_SCL
PA9.Signal=USB_OTG_FS_VBUS
PB1.GPIO_Label=SD_CARDSW
PB1.Signal=GPIO_Input
PB10.GPIO_Label=HUB_SCL
PB10.Signal=I2C2_SCL
PB12.GPIO_Label=HUB_RESET
PB12.Signal=GPIO_Output
PB2.Signal=SDIO_CK
PB3.Signal=SYS_JTDO-SWO
PB4.Signal=I2C3_SDA
PB5.GPIO_Label=LSM_INT2ACCL
PB5.Signal=GPIO_Input
PB6.Signal=QUADSPI_BK1_NCS
PB7.GPIO_Label=MPU_CLKIN
PB7.Signal=GPIO_Output
PB8.Signal=I2C1_SCL
PB9.Signal=I2C1_SDA
PC0.GPIO_Label=BUTTON1
PC0.Signal=GPIO_Input
PC1.GPIO_Label=BUTTON2
PC1.Signal=GPIO_Input
PC10.Signal=SDIO_D2
PC11.Signal=SDIO_D3
PC12.GPIO_Label=HUB_SDA
PC12.Signal=I2C2_SDA
PC2.GPIO_Label=BUTTON3
PC2.Signal=GPIO_Input
PC3.GPIO_Label=BUTTON4
PC3.Signal=GPIO_Input
PC6.GPIO_Label=LSM_INTMAG
PC6.Signal=GPXTI6
PC7.GPIO_Label=LSM_INT1ACCL
PC7.Signal=GPIO_Input
PC8.Signal=SDIO_D0
PC9.Signal=SDIO_D1
PD11.Signal=QUADSPI_BK1_IO0
PD12.Signal=QUADSPI_BK1_IO1
PD13.Signal=QUADSPI_BK1_IO3
PD14.GPIO_Label=OLED_SCL
PD14.Signal=FMPI2C1_SCL
PD15.GPIO_Label=OLED_SDA
PD15.Signal=FMPI2C1_SDA
PD2.Signal=SDIO_CMD
PD3.Signal=QUADSPI_CLK
PE0.GPIO_Label=MPU_INT
PE0.Signal=GPXTI0
PE1.GPIO_Label=MPU_FSYNC
PE1.Signal=GPIO_Output
PE10.GPIO_Label=ADIS_RESET
PE10.Signal=GPIO_Output
PE11.GPIO_Label=ADIS_DR
PE11.Signal=GPXTI11
PE12.Signal=SPI4_SCK
PE13.Signal=S_TIM1_CH3
PE14.Signal=S_TIM1_CH4
PE15.GPIO_Label=PWR_OFF
PE15.Signal=GPIO_Output
PE2.Signal=QUADSPI_BK1_IO2
PE4.GPIO_Label=LED1
PE4.Signal=GPIO_Output
PE5.GPIO_Label=LED2
PE5.Signal=GPIO_Output
PE6.GPIO_Label=LED3
PE6.Signal=GPIO_Output
PE8.GPIO_Label=ADIS_CS
PE8.Signal=GPIO_Output
PE9.GPIO_Label=ADIS_SYNC
PE9.Signal=GPIO_Output
PH0-OSC_IN.Signal=RCC_OSC_IN
PH1-OSC_OUT.Signal=RCC_OSC_OUT
