marouncz/GraviGon/(commit log)

2025-02-20 addon pcb kicad project
    [IMUnav_Gravi_Addon.kicad_pcb, IMUnav_Gravi_Addon.kicad_sch]
2025-02-20 addon pcb, added 3d models
    [IMUnav_Gravi_Addon.kicad_pcb, MT3608 v3.step, bmp280_module.stp]
2025-02-21 addon pcb routing
    [IMUnav_Gravi_Addon.kicad_pcb, IMUnav_Gravi_Addon.kicad_sch]
2025-02-26 nákupní seznam
    [Nákupní seznam.xlsx]
2025-03-02 update for manufacturability with npth vias
    [IMUnav_Gravi_Addon.kicad_pcb, Nákupní seznam.xlsx, bom.csv, designators.csv, positions.csv]
2025-04-13 pressure, new logger
2025-04-13 fixed fatfs problems, logging struct update
    [GraviGon_F00.ioc, main.h]
2025-04-13 logger and binary decoder
    [output.csv]
2025-04-13 filesystem sync to save data when power outage
    [output.csv]
2025-04-13 logging magnetometer
2025-04-14 holedná test fall
2025-04-14 holedná fail
    [output.csv]
2025-04-14 imunav board
    [ESP32.kicad_sch, GPS.kicad_sch, IMU.kicad_sch, IMUnav_H00.kicad_pcb, IMUnav_H00.kicad_sch, Memory.kicad_sch, USB+Power.kicad_sch, User.kicad_sch]
2025-04-23 failsafe button, bilovice test
    [accelFailed.csv, output.csv]
2025-05-04 3D model update
    [BOM_Screws_Nuts.xlsx, Cubesat_Fuse_Wire.SLDPRT, Cubesat_Moving_Part_v2.SLDPRT, Cubesat_SG90.SLDASM, Cubesat_Side_Parachute_Cover.SLDPRT, Cubesat_Side_Parachute_Cover.STL]
