marouncz/GraviGon/(notices)

Notices in the files:
Software/GraviGon_F00/Core/Inc/quadspi.h:
Copyright (c) 2024 STMicroelectronics.
All rights reserved.
This software is licensed under terms that can be found in the LICENSE file
